Deejpotter/idex-3d-printer/cad/mass-report.csv

part | qty | mass_g_each | mass_g_total | material
688ZZ Bearing | 4 | 5.92 | 23.68 | Steel
8mm Acme Anti Backlash Nut Block | 2 | 55.00 | 110.00 | MASS POM anti-backlash nut
8mm x 500mm Lead Screw | 2 | 153.24 | 306.49 | Steel
Base cross 2040 | 2 | 356.39 | 712.77 | Aluminum 6061
Base rail 4040 | 2 | 655.24 | 1310.48 | Aluminum 6061
Bay rail bottom | 1 | 240.76 | 240.76 | MASS 2020 extrusion
Bay rail mid | 1 | 240.76 | 240.76 | MASS 2020 extrusion
Bay rail top | 1 | 240.76 | 240.76 | MASS 2020 extrusion
Bed carrier bar F | 1 | 111.04 | 111.04 | Aluminum 6061
Bed carrier bar R | 1 | 111.04 | 111.04 | Aluminum 6061
Bed carrier spine | 1 | 32.39 | 32.39 | Aluminum 6061
Bed levelling spacers | 1 | 8.00 | 8.00 | MASS Bed levelling spacers
Bed rail 2020 | 2 | 245.28 | 490.56 | Aluminum 6061
Belt A lower | 1 | 4.80 | 4.80 | MAT GT2 belt
Belt A upper | 1 | 4.80 | 4.80 | MAT GT2 belt
Belt B lower | 1 | 4.80 | 4.80 | MAT GT2 belt
Belt B upper | 1 | 4.80 | 4.80 | MAT GT2 belt
Electronics panel | 1 | 164.74 | 164.74 | MAT Bubbleboard 6mm
Enc door awning | 1 | 324.21 | 324.21 | MAT Bubbleboard 6mm
Enc panel L | 1 | 377.78 | 377.78 | MAT Bubbleboard 6mm
Enc panel R | 1 | 377.78 | 377.78 | MAT Bubbleboard 6mm
Enc panel rear | 1 | 337.97 | 337.97 | MAT Bubbleboard 6mm
Enc panel top | 1 | 344.65 | 344.65 | MAT Bubbleboard 6mm
Enc post FL | 1 | 240.76 | 240.76 | MASS 2020 extrusion
Enc post FR | 1 | 240.76 | 240.76 | MASS 2020 extrusion
Enc post RL | 1 | 240.76 | 240.76 | MASS 2020 extrusion
Enc post RR | 1 | 240.76 | 240.76 | MASS 2020 extrusion
Enc top rail F | 1 | 240.76 | 240.76 | MASS 2020 extrusion
Enc top rail L | 1 | 226.87 | 226.87 | MASS 2020 extrusion
Enc top rail R | 1 | 240.76 | 240.76 | MASS 2020 extrusion
Enc top rail X | 1 | 226.87 | 226.87 | MASS 2020 extrusion
Extruder Orbiter A | 1 | 132.68 | 132.68 | MASS Extruder Orbiter
Extruder Orbiter B | 1 | 132.68 | 132.68 | MASS Extruder Orbiter
GT2 idler pulley (5 mm bore) v1 | 5 | 7.40 | 37.00 | Steel
Heated bed 255x245 | 1 | 588.27 | 588.27 | MASS Heated bed 235x235
Hotend V6 A | 1 | 106.35 | 106.35 | MASS Hotend V6
Hotend V6 B | 1 | 106.35 | 106.35 | MASS Hotend V6
Hotend fan 4010 A | 1 | 16.00 | 16.00 | MASS Hotend fan 4010
Hotend fan 4010 B | 1 | 16.00 | 16.00 | MASS Hotend fan 4010
MGN12 rail X | 1 | 334.89 | 334.89 | Steel
MGN12 rail Y | 2 | 301.40 | 602.79 | Steel
MGN12 rail Z | 2 | 269.12 | 538.23 | Steel
MGN12H block | 10 | 53.47 | 534.67 | MAT MGN12H block
Magnetic sheet | 1 | 90.00 | 90.00 | MASS Magnetic sheet
Nema 17 Stepper Motor | 4 | 390.00 | 1560.00 | MASS NEMA 17 (LDO 48mm)
Octopus Pro V1.1 | 1 | 180.00 | 180.00 | MASS board
PEI spring steel | 1 | 215.00 | 215.00 | MASS PEI spring steel
PSU LRS-200-24 | 1 | 1025.38 | 1025.38 | MASS PSU
PSU LRS-350-24 | 1 | 1300.00 | 1300.00 | MASS PSU
Part fan 5015 A | 1 | 35.00 | 35.00 | MASS Part fan 5015
Part fan 5015 B | 1 | 35.00 | 35.00 | MASS Part fan 5015
Toolhead plate A | 1 | 158.24 | 158.24 | Aluminum 6061
Toolhead plate B | 1 | 158.24 | 158.24 | Aluminum 6061
Top tie 2040 | 1 | 421.19 | 421.19 | Aluminum 6061
Upright 4040 | 2 | 618.92 | 1237.85 | Aluminum 6061
X beam 2040 | 1 | 421.19 | 421.19 | Aluminum 6061
X belt clamp A | 1 | 32.22 | 32.22 | Steel
X belt clamp B | 1 | 32.22 | 32.22 | Steel
X idler bracket A | 1 | 37.07 | 37.07 | Aluminum 6061
X idler bracket B | 1 | 35.12 | 35.12 | Aluminum 6061
X motor mount A | 1 | 46.18 | 46.18 | Aluminum 6061
X motor mount B | 1 | 46.18 | 46.18 | Aluminum 6061
Y belt clamp | 1 | 59.45 | 59.45 | Aluminum 6061
Y belt run 1 | 1 | 4.48 | 4.48 | MAT GT2 belt
Y belt run 2 | 1 | 4.48 | 4.48 | MAT GT2 belt
Y idler bracket | 1 | 37.20 | 37.20 | Aluminum 6061
Y motor mount | 1 | 67.79 | 67.79 | Aluminum 6061
Z belt run 1 | 1 | 4.04 | 4.04 | MAT GT2 belt
Z belt run 2 | 1 | 4.04 | 4.04 | MAT GT2 belt
Z carriage plate L | 1 | 155.52 | 155.52 | Aluminum 6061
Z carriage plate R | 1 | 155.52 | 155.52 | Aluminum 6061
Z motor mount | 1 | 189.02 | 189.02 | Steel
Z screw block base L | 1 | 35.91 | 35.91 | Aluminum 6061
Z screw block base R | 1 | 35.91 | 35.91 | Aluminum 6061
Z screw block top L | 1 | 38.47 | 38.47 | Aluminum 6061
Z screw block top R | 1 | 38.47 | 38.47 | Aluminum 6061
pulley gt2 6.35 bore | 6 | 15.32 | 91.94 | Steel
