Deejpotter/idex-3d-printer/cad/idex-printer-assembly.step

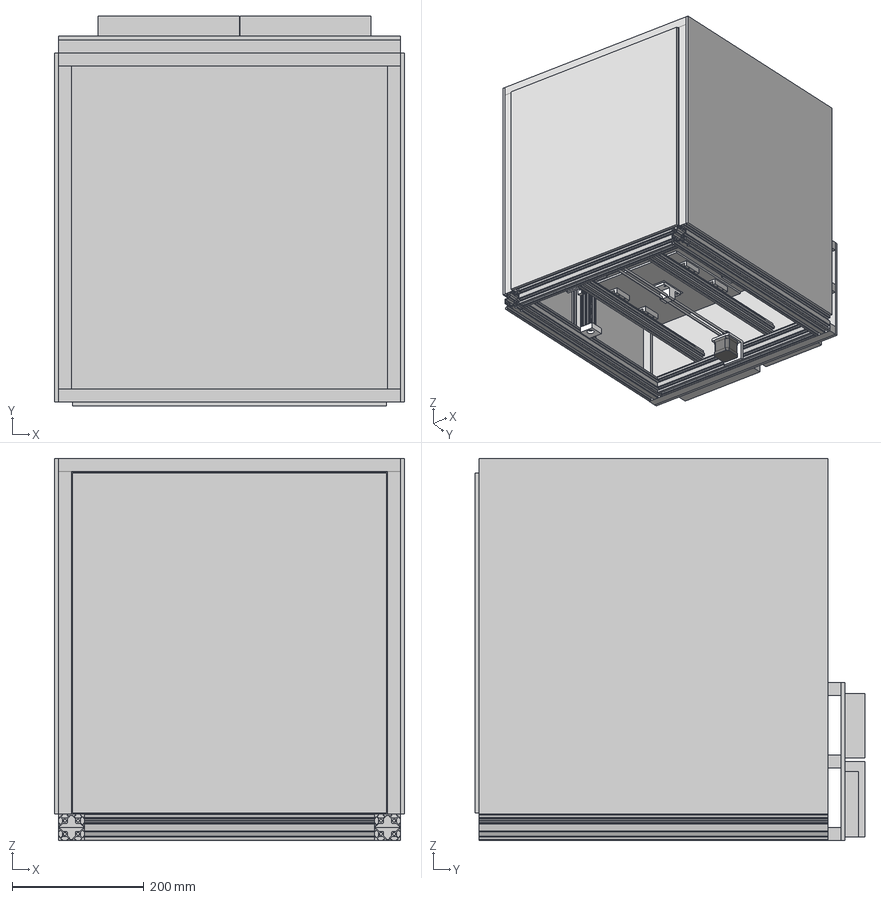
[picture p3: CAD file, 2026-11-12]
cad/idex-printer-assembly.step
532.0 x 592.0 x 580.0 mm
pulley gt2 6.35 bore x 6
GT2 idler pulley (5 mm bore) x 5
Nema 17 Stepper Motor x 4
Trapezoidal lead screw tr8x8-4 x 2
8mm Acme Anti Backlash Nut Block x 2
688ZZ Bearing x 4
