Deejpotter/idex-3d-printer/(list of files, cad)

Other CAD files:
cad/idex-printer-assembly.f3d
