Deejpotter/idex-3d-printer/docs/build-spec.html

Build notes · 10 Nov 2026 · replaces the Apr 2025 Dual 3D Printer

# Cheap Fast IDEX

A dual-extrusion printer, direct drive, as cheap as possible and as fast as the frame allows — built on the layout you already drew. This version explains the reasoning rather than just stating it, so you can argue with the conclusions.

Lesson 1

## A printer is a weight on the end of a spring

Pin a ruler to the edge of a desk, flick the free end, and it wobbles at one particular rate. Not a random rate — one specific one. Make the ruler stick out further and the wobble slows down. Stick a lump of Blu-Tack on the end and it slows down again.

Your print head is that ruler. It hangs off a belt, which hangs off brackets, which bolt to a frame. All of that flexes a little. So when a motor yanks the head sideways and then stops, the head keeps wobbling for a moment. That wobble prints as ringing — the faint repeated echo you see just after a sharp corner.

The rate it wobbles at is the natural frequency, measured in hertz (Hz, wobbles per second). It depends on exactly two things:

natural frequency = (1 ÷ 2π) × √( stiffness ÷ mass )

Stiffness is how hard the structure resists being pushed out of shape, in newtons per metre (N/m) — push with so many newtons, it deflects so many metres. A high number is a rigid thing. Mass is simply the weight that's moving, in kilograms.

In plain terms

Stiffer frame → faster wobble → better. Heavier head → slower wobble → worse. Those are your only two levers, and the square root means you need to quadruple stiffness, or quarter the mass, to double the frequency.

Why do we want a fast wobble? Because a fast wobble dies out quickly and is easier for the firmware to cancel. That's the next two lessons.

Lesson 2

## In a chain of springs, the floppiest one wins

This is the idea that decides your whole build, so it's worth getting properly.

The head isn't connected to the motor by one spring. It's a chain: the belt stretches a bit, the bracket holding the motor flexes a bit, the frame those bolt to bends a bit. Springs in a chain like this are called springs in series.

Here's the counterintuitive bit. If you hook a very stiff spring to a very floppy one, the pair is floppier than the floppy one alone. Pull on the chain and the floppy one does nearly all the stretching. Making the stiff one even stiffer changes almost nothing.

The belt is nearly seven times stiffer than the bracket, and contributes almost nothing. Replace the belt with an infinitely rigid steel bar and you'd get 60,000 instead of 52,000 — a 15% gain. Double the bracket stiffness and you get 92,000 — a 77% gain.

This is why people's intuition about printers is usually wrong. Everyone obsesses over belt tension and carriage weight. The actual floppy link is nearly always the printed plastic bracket holding the motor or the idler pulley.

How we know the model is right

If you calculate using the belt alone, you predict the X axis wobbles at 123 Hz. Real bedslingers measure 32–45 Hz. The gap is the brackets. Once they're included, the model lands on 32.5 Hz for a printed-bracket machine — which is what an Ender 3 actually measures. That's the check that says these numbers can be trusted.

Lesson 3

## What the wobble costs you in speed

Modern firmware can cancel ringing. The trick is called input shaping: the firmware knows your wobble frequency, so when it commands a sharp move it splits it into two nudges, timed so the second nudge's wobble cancels the first one's. Like catching a swing at exactly the right moment to stop it dead.

It works brilliantly, but it has a price. The two nudges are spread over time, which slightly smears sharp corners. The faster you accelerate, the more smearing. And the lower your wobble frequency, the further apart the nudges must be, so the worse the smearing at any given acceleration.

That gives a practical ceiling on acceleration, roughly:

max acceleration (mm/s²) ≈ frequency² × 0.022

The square is what matters. Going from 30 Hz to 60 Hz doesn't double your acceleration — it quadruples it.

What frequency buys you
Frequency | Usable acceleration | Feels like
22 Hz | 1,000 mm/s² | a tired old bedslinger
33 Hz | 2,400 mm/s² | stock Ender 3
45 Hz | 4,500 mm/s² | a good budget build
55 Hz | 6,700 mm/s² | genuinely quick
65 Hz | 9,300 mm/s² | Voron territory

"Acceleration" in mm/s² is how hard the head can change speed. It matters more than top speed, because on a real part full of short segments and corners the head spends most of its life speeding up and slowing down and never reaches top speed at all.

Lesson 4

## Your machine, with those rules applied

Now we can just read the answers off. Two axes move fast: X (the print head sliding along the beam) and Y (the bed sliding back and forth — a layout called a bedslinger, which is what you drew).

### The X axis — the print head

X carriage, three bracket choices
Head build | Mass | Printed brackets | Ribbed + inserts | Aluminium
Your Titan + low-profile NEMA 17 owned | 667 g | 29.9 Hz | 44.5 Hz | 64.4 Hz
A light geared extruder would cost ~$120 | 385 g | 39.3 Hz | 58.6 Hz | 84.7 Hz

Read that across, not down. Buying a fancy light extruder and keeping printed brackets gets you 39 Hz. Keeping the extruder you already own and making the brackets from aluminium gets you 64 Hz — and costs less.

The main recommendation

Don't buy lightweight extruders. Buy aluminium brackets. Your existing Titans and low-profile NEMA 17s are fine for direct drive. Mass is the lever everyone reaches for; stiffness is the lever that actually moves.

### The Y axis — the bed

Y bed, same three bracket choices
Bed build | Mass | Printed | Ribbed | Aluminium
As you drew it — 235 bed plus a 185 support plate | 1300 g | 21.6 Hz | 32.5 Hz | 48.1 Hz
Bed mounted straight to the rail blocks | 1020 g | 24.4 Hz | 36.7 Hz | 54.3 Hz
Drop to a 200 × 200 bed | 850 g | 26.7 Hz | 40.2 Hz | 59.5 Hz

Y is slower than X in every single row, because the bed is heavier than the head. And the firmware applies one acceleration limit to the whole machine, so the machine runs at whichever axis is worse. Money spent making X faster than Y buys you nothing at all.

A free improvement

Your design has a 235 mm heated bed and a separate 185 mm support plate underneath it. Bolt the bed straight to the linear rail blocks and you delete 280 g, lifting Y by about 12%. It costs nothing and removes a part.

Where the whole machine lands
Build | X | Y | Machine runs at
Printed brackets, bed as drawn | 2,000 | 1,000 | 1,000 mm/s²
Ribbed printed brackets, support plate deleted | 4,400 | 3,000 | 3,000 mm/s²
Aluminium brackets, support plate deleted | 9,100 | 6,500 | 6,500 mm/s²
Aluminium + 200 mm bed + light extruders | 15,800 | 7,800 | 7,800 mm/s²

The third row is the sweet spot: six and a half times the acceleration of the first, bought almost entirely with bracket material and one deleted part.

Lesson 5

## Your extrusion choice, checked

You want to stay on 20-series V-slot so the parts stay reusable. Good news: the numbers say that's nearly free.

The frame is a third spring in that chain from Lesson 2. By the floppiest-link rule, it only matters if it's as floppy as the bracket. Stiffness of a beam comes from its second moment of area (symbol I, in cm⁴) — a number describing how the metal is distributed about the bending axis. Material far from the centre counts enormously more, which is why a tall profile stood on edge is so much stiffer than a square one.

Every profile, for reference — X beam 600 mm span, upright 400 mm cantilever
Profile | I (cm⁴) | X beam stiffness | Upright stiffness | X frequency | Accel
2020 V-slot | 0.70 | 107 kN/m | 23 kN/m | 36.5 Hz | 2,900
2040 V-slot | 4.65 | 713 kN/m | 150 kN/m | 43.0 Hz | 4,100
2060 V-slot | 14.5 | 2,223 kN/m | 469 kN/m | 44.0 Hz | 4,300
2080 V-slot | 32.5 | 4,983 kN/m | 1,051 kN/m | 44.3 Hz | 4,300
3030 T-slot | 3.60 | 552 kN/m | 116 kN/m | 42.5 Hz | 4,000
3060 T-slot | 22.5 | 3,450 kN/m | 728 kN/m | 44.2 Hz | 4,300
4040 T-slot | 9.00 | 1,380 kN/m | 291 kN/m | 43.7 Hz | 4,200
4080 T-slot | 50.0 | 7,667 kN/m | 1,617 kN/m | 44.4 Hz | 4,300

Read the frequency column and the profiles all look the same — 2040 gives 43.0 Hz, 4080 gives 44.4 Hz. That table assumes printed brackets, though, and a printed bracket is so floppy it swamps everything behind it. Once you fit the aluminium brackets from Lesson 4, the bracket stops being the worst link and the frame starts to show.

### First, a correction: 40×40 V-slot is 20-series

You used 40 × 40 V-slot for the uprights, not 2040 — and that's still 20-series hardware: the same M5 T-nuts, the same 20 mm slot pitch, the same accessories. "20-series" describes the slot, not the outside dimension, so staying reusable never meant staying small. 40×40 V-slot has an I of about 7.5 cm⁴ against 2040's 4.65, and a pair of 400 mm uprights gives 485 kN/m rather than 301.

So your original choice was already better than what I assumed. But it turns out the extrusion was never the thing to worry about.

### Redone with aluminium brackets — and with the uprights counted

The X beam isn't the only frame member in the chain. When the head accelerates along the beam, the whole gantry reacts, and the two Z uprights sway. They're a cantilever — fixed at the bottom, free at the top — which is a much floppier arrangement than a beam supported at both ends.

Same profile for beam and uprights, aluminium brackets
Profile | Beam | Two uprights | Chain total | X frequency | X accel
2020 | 107 kN/m | 45 kN/m | 24.7 kN/m | 30.6 Hz | 2,100
2040 | 713 kN/m | 301 kN/m | 72.0 kN/m | 52.3 Hz | 6,000
2060 | 2,223 kN/m | 938 kN/m | 93.6 kN/m | 59.6 Hz | 7,800
2080 | 4,983 kN/m | 2,102 kN/m | 101.6 kN/m | 62.1 Hz | 8,500

So the profile does matter after all, once the brackets are good: 2040 → 2060 is worth 30% more acceleration. But the next question is where to spend it, and the answer is not the obvious one.

Upgrading one member at a time
Beam / uprights | X frequency | X accel | Gain
2040 beam / 2040 uprights | 52.3 Hz | 6,000 | —
2060 beam / 2040 uprights | 54.2 Hz | 6,500 | +8%
2040 beam / 2060 uprights | 57.1 Hz | 7,200 | +20%
2060 beam / 2060 uprights | 59.6 Hz | 7,800 | +30%
2080 beam / 2080 uprights | 62.1 Hz | 8,500 | +42%

The uprights matter more than the beam

Upgrading the uprights alone buys +20%. Upgrading the beam alone buys +8%. Two 2040 uprights together give 301 kN/m against the beam's 713 — they are the floppier of the two, so by Lesson 2 they're where the gain is. Most people would have upgraded the beam.

### But remember what caps the machine

Y runs at 6,500 mm/s² with aluminium brackets and the support plate deleted, and the firmware uses one limit for the whole machine. So:

Build | X can do | Y can do | Machine runs at
2040 beam / 2040 uprights | 6,000 | 6,500 | 6,000 — X-limited
2040 beam / 2060 uprights | 7,200 | 6,500 | 6,500 — Y-limited
2060 beam / 2060 uprights | 7,800 | 6,500 | 6,500 — no further gain
2080 everywhere | 8,500 | 6,500 | 6,500 — no further gain

What to actually buy: nothing

- Your 40×40 V-slot uprights are already enough. They give X 6,600 mm/s², which just clears Y's 6,500. Buying 2060 would take X to 7,200 and leave the machine at 6,500 regardless.
- X beam: 2040 on edge is enough — unless you later drop to a 200 mm bed, which lifts Y to 7,800 and makes a 2060 beam worth revisiting.
- Never 2020 for a beam or upright. Two 2020 uprights are 45 kN/m, floppier than the bracket itself, and drag the machine to 2,100 mm/s².
- Bed carrier: 2020 is fine — it moves, so keep it light.

The 30- and 40-series T-slot rows in the reference table are kept for if you ever scale this design up. On this machine they'd buy nothing — and now that the uprights are settled, Lesson 10 shows what actually does.

Since every axis runs on MGN linear rails — proper steel rails with recirculating ball bearings, rather than wheels — you never need the V-groove for motion. It's purely a bonus for mounting things later, which is exactly the reusability you're after.

Lesson 6

## Motor torque, and why you don't need a NEMA 23

Torque is twisting force, measured in newton-metres (Nm). One newton-metre is a one-newton push on the end of a one-metre lever — roughly the force of holding up a 100 g apple, a metre out.

A belt motor's lever is the radius of its pulley. Your GT2 20-tooth pulley has a working radius of only 6.366 mm, so the motor has a very short lever. That sounds bad but it's the opposite: a short lever means a small torque produces a large pull on the belt. It's gearing in your favour.

torque needed = mass × acceleration × pulley radius (+ a bit to spin the motor's own rotor)

Work it through for the heaviest demand on the machine and the answer is almost embarrassing:

Torque demanded vs a standard NEMA 17's 0.45 Nm
Axis | Motor | Needs | Spare | Have it?
X1 — carriage A | NEMA 17, 42×40 | 0.060 Nm | 7.5× | owned
X2 — carriage B | NEMA 17, 42×40 | 0.060 Nm | 7.5× | owned
Y — bed | NEMA 17, 42×40 | 0.044 Nm | 10.2× | owned
Z — both lead screws | NEMA 17, 42×40 | 0.175 Nm | 2.6× | buy 1
E1 — extruder | Low-profile NEMA 17 | 0.080 Nm | 5.6× | owned
E2 — extruder | Low-profile NEMA 17 | 0.080 Nm | 5.6× | owned

"NEMA 17" is just a mounting standard — it means a 42 × 42 mm faceplate, nothing about power. NEMA 23 means 57 × 57 mm.

The hardest-working axis on the whole printer is Z, lifting the gantry on two lead screws, and it asks for 0.175 Nm. A NEMA 23 delivers 1.0–2.0 Nm. That's six to eleven times more than the worst case anywhere on the machine, for an extra ~700 g of motor and about 2.8 amps — which is more current than a TMC2209 driver chip can give, so you'd have to buy external drivers as well. On a build where the goal is cheap, it's spending money to gain nothing.

Answer to your question

No NEMA 23. Keep the single NEMA 17 belt-linking both lead screws, exactly as you have it — it has 2.6× margin, which is healthy. You own five of the six motors you need; buy one standard NEMA 17.

Lesson 7

## Why motors go weak when they spin fast

A spinning motor acts as a generator, pushing back a voltage of its own against the supply. This is back-EMF (electromotive force — just an old word for voltage). The faster it spins, the harder it pushes back.

Your power supply has to overcome that back-voltage before any current can flow into the coils, and current is what makes torque. When back-EMF approaches your supply voltage, current stops flowing and the motor goes limp — no matter how beefy it is.

Voltage left over after back-EMF ("headroom")
Head speed | Motor rpm | Back-EMF | on 12 V | on 24 V | on 36 V
200 mm/s | 300 | 11.0 V | 1.0 V | 13.0 V | 25.0 V
300 mm/s | 450 | 16.5 V | −4.5 V | 7.5 V | 19.5 V
400 mm/s | 600 | 22.0 V | −10.0 V | 2.0 V | 14.0 V
500 mm/s | 750 | 27.5 V | −15.5 V | −3.5 V | 8.5 V

A negative number means the motor is generating more voltage than you're feeding it — it simply cannot go that fast. On 12 V you run out at about 250 mm/s. On 24 V you reach roughly 400 mm/s, which is past what the frame can use anyway.

Decision

24 V. It is the cheapest single thing you can do for speed. 36 V would go further but costs more and narrows your board options for no benefit you could actually use.

### Power supply size

What draws power | Watts
Heated bed, 235 × 235 | 199
Two hotends, 40 W each | 80
Six stepper motors | 60
Cooling fans | 25
Controller and single-board computer | 15
Total | 379 W — that's 15.8 A at 24 V

A 24 V 500 W supply leaves 32% spare. The bed is over half the total, so a smaller bed later would let you drop to 400 W.

Lesson 8

## What IDEX actually is, and what it costs

IDEX stands for Independent Dual EXtruder. Two complete print heads sit on the same beam, each with its own motor and its own belt, so either can move while the other sits parked at the end.

Compare that to the E3D Chimera in your current design, which is one block with two nozzles side by side, both always moving together. The idle nozzle drags over your print and dribbles on it. IDEX parks the idle nozzle off to the side instead, which is the main reason it gives cleaner dual-colour results.

IDEX also unlocks duplicate mode: both heads print the same object at the same time, two copies in the time of one. That's a genuine throughput win rather than a convenience.

The cost is beam length. Both heads need to reach the whole bed, and both need somewhere to park clear of it:

Measurement | Value | Note
Bed width | 235 mm | your existing bed
Carriage width | 65 mm | a compact direct-drive head
Travel needed | 385 mm | bed + both parking spots
MGN12 rail length | 450 → buy 500 mm | your longest is 350 mm
X beam length | ~600 mm | plus both motor mounts
Build volume | 235 × 235 × 250 | single head
Duplicate mode | 85 mm per copy | two at once

Your 390 mm beam is simply too short for this. A ~600 mm length of 2040 or 2060 fixes it.

### Why direct drive was the right call

Direct drive means the motor that pushes filament sits on the moving head. Bowden means it sits on the frame and pushes filament down a long tube. Bowden gives a lighter head, but the filament squashes inside that tube like a spring, so when you command a retraction the nozzle responds late and vaguely.

For dual extrusion that matters more than usual, because precise retraction is exactly what stops the parked nozzle oozing. You chose direct drive, and Lesson 4 shows the mass penalty barely costs you anything once the brackets are aluminium. It's the right call.

Lesson 9

## Making the brackets: mill them, or buy them?

Before the cost question, something that changes what "a stiff bracket" even means.

Take a 3 mm aluminium plate, 70 mm wide, sticking out 40 mm. Push on it two different ways:

How the load hits it | Stiffness
Across the face — bending it like a diving board | 509 kN/m
In the plate's own plane — pushing along it edge-on | 500× stiffer

Same plate, same metal, same bolts. The only difference is which way the force arrives. Think of a sheet of paper: floppy flat, but almost impossible to squash edge-on.

So "aluminium bracket" was shorthand

What Lesson 4 really wants is a bracket that isn't loaded in bending. A cheap 3 mm bought plate, turned the right way, beats a thick milled block turned the wrong way. Orientation matters more than material or thickness.

Design every motor and idler mount so the belt pulls along the plate, not across it. Standard V-slot motor plates are already designed this way — the motor bolts to the face and the belt runs in the plate's plane. Use at least two bolts into the extrusion, with proper T-nuts; past that point the bolted joint is the limit, not the plate, which lands you around the 150 kN/m "aluminium" column.

### Now the cost question

CNC Kitchen measured an A350 — stiffer than your A250 — cutting 4 mm aluminium at 250 mm/min with a 0.3 mm stepdown, with heavy chatter. Taking that as the optimistic case for a 70 × 40 × 6 mm bracket with six holes:

Step | Time
20 passes round the perimeter | 17.6 min
Six holes | 3.8 min
Workholding, probing, tool change, tabs, cleanup | 30 min
Per bracket | 51 min, supervised
Ten brackets | 8.6 hours

Four ways to get ten brackets
Option | Parts cost | Your time | Catch
Mill on the Snapmaker | ~$100 | 8.6 h | chatter finish, broken end mills, ten setups
Maker Store plates | ~$145 | 0.5 h | dearest, but local and known to fit
AliExpress plates | ~$55 | 0.5 h | 2–5 week shipping, QC lottery
Laser cut custom, AU | ~$160 | 1.0 h | any shape, single piece, ~5 business days

Milling costs roughly what the plates cost — the 6061 stock is ~$50 and you'll get through three or more carbide single-flute end mills at ~$15 each — and then asks for 8.6 hours of supervised machine time on top, to produce parts with a worse finish and less accuracy than stamped plates. The A250 isn't rigid enough for aluminium to be pleasant; it's a job it can do, not one it's good at.

Answer

Buy the plates and design around them. Your existing model already uses this ecosystem — Easy Build Plate 3×6, V-Slot Gantry Plate 20 mm, Threaded Rod Plate NEMA 17, Black Angle Corner Connector are all standard catalogue parts. Carry on doing that.

AliExpress for the standard shapes since it's your preference and it's a third of the price; order early and order spares, because the shipping is the real cost. Maker Store for anything you need this week or need to be certain fits.

For the two or three brackets where no standard plate works, draw them as flat 2D profiles and have them laser cut rather than milled. Ferracut in Dandenong takes DXF uploads and cuts aluminium up to 12 mm — about half an hour from you. A single-piece laser-cut bracket is stiffer than bolting two plates together, and you skip the 8.6 hours.

Keep the Snapmaker's CNC for one-offs you need the same day, and for the jobs it's genuinely good at — wood, acrylic, carbon fibre.

Lesson 10

## How it all bolts together — and where I had this wrong

You pushed back on this and you were right. I went back into the assembly and read it properly this time: every occurrence, every transform, every fastener position. Several things I told you earlier were wrong, and the correction changes the whole recommendation.

Corrections

- The assembly has 294 occurrences, not 77. (77 is just the Frame's child count — I quoted a sub-total as the whole.)
- It has 153 fasteners, not 140.
- It records 2 joints and 4 rigid groups across all 294 occurrences, with 0 user parameters and a 539-item timeline. Position is held by captured snapshots, not constraints.
- And the big one: the upright feet are already reinforced. I said they weren't.

### What the feet actually do

Each upright is a 40 × 40 V-slot sitting on a 40 × 40 base rail, and each foot carries:

- 4 × M5 blind screws up through the base rail's top wall into the four tapped bores of the upright — a 2 × 2 pattern at ±10 mm, which is exactly the 4040's four cell centres. All four are used.
- 2 × 90° joining plates on the outer face, 4 mm thick, 10 M5 screws between them. All four plates in the design are at the upright feet — not "all up in the Z assembly" as I claimed.

### Why blind joining is the strong option — your instinct was correct

A bolted butt joint is not a hinge with a spring in it. Once the bolts are preloaded, the two end faces are clamped together, and the joint behaves as effectively rigid right up until the moment that tries to pull the faces apart exceeds the clamping force. That is called gapping, and until it happens the joint is as stiff as solid metal.

Four M5 bolts at ±10 mm, preloaded to even a conservative 2.5 kN each, resist gapping up to roughly 130 N·m. The moment this machine actually applies at an upright foot — the toolhead at 1.42 kg accelerating hard, 350 mm up — is about 3 N·m. You are a factor of forty inside the limit. The joint never gaps, never slips, and never becomes the floppy spring I modelled it as.

My earlier figure of 91 kN/m effectively modelled a single centre bolt. That is the case where blind joining is genuinely weak, and it is where the "always use corner brackets" folklore comes from. With all four bores used, it does not apply.

Same 40 × 40 uprights, 350 mm, four ways of fixing the bottom — corrected
How the upright meets the base | Pair stiffness | X frequency | Machine accel | Gain
4 blind bolts — what you drew | 478 kN/m | 40.1 Hz | 3,546 | —
Plus a gusset on the loaded face | 636 kN/m | 41.0 Hz | 3,719 | +5%
Plus gussets on both loaded faces | 670 kN/m | 41.2 Hz | 3,747 | +6%
A perfectly rigid, welded foot | 724 kN/m | 41.4 Hz | 3,787 | +7%

Read the last column. Even replacing the foot with a weld buys 7%. I previously told you this joint was worth +51% and that it outweighed everything in Lesson 5. It is worth almost nothing. Forget the eight corner brackets; do not buy them.

### So where does the speed actually go? Back to Lesson 2

The floppiest spring wins, and once the foot is modelled correctly the floppiest spring is the one Lesson 4 already pointed at — the toolhead mount. A 576 g plate hanging off a single MGN12H block is roughly 141 kN/m, against 513 for the belt and 478 for the gantry. It is three times floppier than anything else in the chain, so it sets the answer on its own.

Changing the mount, with the foot left exactly as you drew it
Toolhead build | Mass | X frequency | Machine accel | Gain
1 × MGN12H + 576 g plate — as drawn | 1.42 kg | 40.1 Hz | 3,546 | —
2 × MGN12H, same heavy plate | 1.47 kg | 47.7 Hz | 5,019 | +42%
2 × MGN12H + 300 g aluminium plate | 1.14 kg | 54.1 Hz | 6,471 | +83%
2 × MGN12H, IDEX carriage ~900 g | 0.90 kg | 60.9 Hz | 8,197 | +131%
2 × MGN12H, light IDEX ~750 g | 0.75 kg | 66.7 Hz | 9,836 | +177%

The corrected headline

Adding a second MGN12H block under each carriage is worth +42% on its own, costs about $8, and needs no change to the frame at all. Every foot-related modification put together is worth 7%. Spend the effort on the carriage, not the corners.

Which machine these numbers describe

Everything in this lesson is your existing design as drawn — the 1.42 kg Chimera head on one block. Lesson 4 costs the rebuild, with a 667 g IDEX carriage, and lands at 6,500 mm/s². In the rebuild the second block still helps X, but the machine is then limited by Y, the bed, so X gains past 6,500 are wasted. Fix the carriage because it is cheap and it unblocks X; after that, every further gain comes from the bed.

### Two things that are genuinely wrong at the feet

The joint type is right. The detailing is not.

Thread engagement, M5 into 6063 aluminium (2.2 mm wall under the head)
Screw | Engagement | Thread strip load | Verdict
M5 × 8 — what the model uses | 5.8 mm | 6.8 kN | too short below the preload you want
M5 × 12 | 9.8 mm | 11.5 kN | marginal — just under 2 × diameter
M5 × 16 | 13.8 mm | 16.3 kN | correct comfortably past 2 × diameter

- Every blind screw in the model is an M5 × 8. Through a 2.2 mm wall that leaves 5.8 mm of thread in aluminium — below the rule of thumb of two diameters, and below the preload the joint needs to stay clamped. Preload is the entire reason a blind joint is stiff, so this is the one detail that could turn your good joint into my bad one. Use M5 × 16 at the feet. It is the cheapest fix in this document.
- Both gussets are on the same face. They sit on the outer X face of each upright, so they resist the upright tipping in Y. The toolhead accelerates in X, which tips the uprights the other way — the plane the gussets do nothing for. They are not harmful and they help the Z-lift loads, but do not count them as X stiffness. Given the table above, it is not worth moving them.

### What the model does not fasten at all

The Frame (64 fasteners), X axis (43) and Z axis (40) are reasonably detailed. Two areas are not, so when you rebuild you will be designing these joints rather than copying them:

- The whole Y axis — zero fasteners. Not one screw in the entire sub-assembly: nothing holding the Y motor mount, the pulley bracket, the bed support plate, the MGN blocks or the bed-levelling hardware. Roughly 20 missing.
- The toolhead — four. Two M3 screws and two M3 nuts, inside one Titan. The carriage plate, both NEMA 17s and both extruder bodies are floating. Another 20 or so.
- The Z top motor has three M4 screws, where a NEMA 17 has four mounting holes.

### Making it easier to assemble

- Drop-in T-nuts everywhere. Never sliding ones. The single biggest assembly-ease win. A sliding T-nut has to be threaded in from the open end before you close that extrusion off — forget one and you dismantle the frame to add it. You already use 32 ball-spring nuts; replace the 10 sliding ones too.
- Buy M5 in 8, 12, 16 and 20 mm. M5 × 8 is right for a T-nut under a 3 mm plate and wrong for almost everything else. The feet need 16.
- Keep a ball-end hex driver. The blind screws go in down a long clearance hole inside the base rail's slot, at an angle a straight key will not reach.
- Build the X beam as a complete unit on the bench — rail, both carriages, both motors, idlers, belts — then lift it onto the Z carriages as one piece.
- Count your T-nuts into each extrusion before you close a corner. Write the number on masking tape. Add two spares per slot.
- Torque the blind screws properly, in a cross pattern, like a wheel. Preload is what makes this joint work; an under-torqued blind bolt really is the floppy hinge I wrongly described.

Lesson 11

## What to buy

Item | Qty | Why
V-slot motor + idler plates, bought not milled | ~10 | highest-value item — Lessons 2, 4 and 9. AliExpress; spares too
Standard NEMA 17 | 1 | you have 3 of the 4 standard motors needed
MGN12 rail, 500 mm | 1 | the X axis; you already own the blocks
Control board with 6+ drivers — BTT Manta M8P + CB1 | 1 | board and computer in one, cheaper than separate
TMC2209 stepper drivers | 6 | one per motor
24 V 500 W power supply | 1 | Lesson 7
V6-class hotends | 2 | IDEX needs two separate heads; a Chimera can't be split
GT2 belt, idlers, 20T pulley | 2nd set | the second X axis
MGN12H carriage blocks — a second one per carriage | 2 | +42% acceleration on the machine as drawn — Lesson 10. About $8 each and no frame change
M5 × 16 button screws, for the upright feet | 8 | the model uses M5 × 8, which leaves only 5.8 mm of thread in aluminium — Lesson 10
Drop-in / ball-spring M5 T-nuts | 60+ | replaces the 10 sliding ones; buy well over what you count
M5 button screws — 8, 12, 16 and 20 mm | assortment | 8 mm alone will not reach through a bracket stack
2040 V-slot — 480 mm X beam, base perimeter | — | 480 mm is derived in the model, not guessed — Lesson 13. Seconds from work; uprights you already have

Surplus: the E3D Chimera is worth selling — it's the opposite of IDEX. So is the 576 g carriage plate.

Lesson 12

## Build order, and the step people skip

# | Step | Why here

1 | Frame — your 40×40 V-slot uprights, 2040 base, tied at the top, all four blind bores used at every foot, with M5 × 16, torqued in a cross pattern | the blind joint is the right one; it just needs enough thread and enough preload — Lesson 10
2 | Belt-linked dual lead-screw Z, lifting the gantry | carries over from your design unchanged
3 | Bed carrier — bed straight onto the rail blocks | it's the limiting axis; fix it first
4 | X beam with one carriage, aluminium brackets | prove it as a single-extruder printer
5 | Measure the resonance. Compare to this report. | the step people skip
6 | Second carriage, second hotend, IDEX config | only once step 5 agrees
7 | Nozzle offset calibration and prime tower tuning | the fiddliest part of commissioning

Step 5 takes an hour. You stick an accelerometer on the head, the firmware shakes the axis and tells you its frequency. If it comes back well below the aluminium column, something is flexing that shouldn't be — and finding that with one carriage on the beam is far easier than with two.

### Three things that bite IDEX builds

- The two carriages won't match. They sit at different distances from their motors, so their belts are different lengths and they ring at different frequencies. The firmware lets you set a different correction per carriage for X, but the Y setting must be identical for both. Keep the two belt paths as close to mirror images as you can.
- The parked nozzle still oozes, just away from your part. You'll want a prime tower — a small sacrificial pillar printed alongside, where each nozzle wipes itself clean before returning.
- Two nozzles means two sets of offsets. You probe with one head, then measure how far the second sits from it in X, Y and Z. Set aside an evening; this is the part that tests patience.

Lesson 13

## The model, rebuilt so it can actually be changed

The old assembly could not be flexed. It had 0 user parameters, 2 joints and 539 timeline items for 294 occurrences, with position held by captured snapshots instead of constraints — so changing one dimension changed nothing else. That blocks every other improvement in this document, so it was the first thing to fix.

There is now a new parametric frame model alongside it. The old one is untouched.

| Old assembly | New frame model
User parameters | 0 | 18
Timeline items | 539 | 16
Sketches fully constrained | — | 8 of 8
Change the build volume and the frame follows | no | yes

### The numbers that drive it

You set the build volume; the frame sizes itself. The one worth understanding is the X beam, because IDEX is what makes it long:

x_beam_len = build_x + 2 × carriage_w + 2 × park_gap + 2 × end_allow

That is the build area, plus a whole carriage parked clear at each end, plus the gap that keeps a parked nozzle off your print, plus room for a motor and an idler. At 230 mm build it comes to 480 mm — not the ~600 mm I guessed earlier. A 500 mm MGN12 rail fits it exactly.

This is the real cost of IDEX, and now you can see it move: widen a carriage from 60 to 75 mm and the beam grows to 510 mm and the whole frame with it. The other drivers are build_y (the frame is 2 × build_y + 60 deep, because a bedslinger needs to swing the bed its full depth), upright_h, and p40 / p20 for the profile faces.

### It uses your real V-slot profiles, not boxes

Your hub already holds the genuine OpenBuilds V-slot parts, in the Extrusion folder of the old project. The problem is they're fixed lengths — 300, 350, 390 mm — and this frame needs 480, 500 and 530. So rather than insert a wrong-length bar, I took the real cross-section off the end face of each part and re-drew it natively, then extruded it to the parametric length.

You get the true profile — every slot, every internal web — with a length that still follows the parameters. The traced sections came out within 0.003 mm² of the originals:

Profile | Section area | Curves traced | Tapped end bores
40 × 40 V-slot | 458.46 mm² | 164 | four, Ø4.6, at (±10, ±10)
20 × 40 V-slot | 299.99 mm² | 112 | two, Ø4.2, at (0, ±10)
20 × 20 V-slot | 171.40 mm² | 69 | one, Ø4.2, dead centre

The real geometry settles Lesson 10

The 4040's four bores sit at exactly (±10, ±10) — the 20 mm pattern the blind-joint calculation assumed, confirmed off your actual part rather than from a catalogue. Your uprights land on all four, which is why that joint is strong.

It also shows where blind joining is weak. The 2020 has a single central bore — that is precisely the one-bolt case my wrong 91 kN/m figure described. Blind-bolting a 2020 end gives you almost no moment resistance. On 2020 members, use a corner bracket; on the 4040 uprights, don't bother.

### How it holds together

Fusion occurrence positions aren't parametric on their own — only lengths are. The first attempt proved it: driving the uprights to 620 mm grew them correctly but left the top tie stranded at its old height. So each real part is now fixed by a rigid joint to the parametric layout body underneath it. Move a parameter, the layout moves, the joints drag the real extrusions with them.

| Old assembly | New model
User parameters | 0 | 29
Timeline items | 539 | 83
Joints | 2 | 10
Real extrusion parts | — | 10 (4.48 kg)
Change the build volume and the frame follows | no | yes

Verified by flexing, not by looking. Uprights to 620, build to 300 × 300, carriage to 80 — the extrusions changed length, the top tie rode up to 660–680, the envelope tracked every step, and everything returned exactly to 480 × 530 × 560 with a clean timeline. Worst placement error anywhere: 0.010 mm, which is the rounding on the profile's outer corners.

Two things worth knowing about how it's built. The six profile sketches are traced real geometry, so they aren't dimensioned — position comes from the joints instead, which is why the layout bodies stay in the file (hidden). And the 20 × 40 members needed their joint angle set explicitly: a rigid joint between two flat faces picks its own rotation about the face normal, and on a non-square profile it lands 90° out.

### Organised by sub-assembly

The model is now grouped the way the machine is built and the way Lesson 15 prices it: A – Frame (7 parts, 3.59 kg), B – X gantry, D – Y and bed, plus empty containers waiting for C – Toolhead A, C – Toolhead B, E – Z axis and G – Electronics. Two toolheads get separate components rather than one mirrored pair, because on an IDEX they genuinely differ — belt side, cable routing, park position.

Regrouping is the kind of change that quietly breaks a parametric model, so it was re-flexed afterwards: upright_h at 620, 440 and back to 500 moved the top tie to 660–680, 480–500 and 540–560, with the envelope tracking and a clean 100-item timeline. All ten rigid joints survived the move.

### What is not in it yet

- Z axis — the belt-linked dual lead screw you want to keep, plus the Z rails and carriages.
- The two IDEX carriages, with two MGN12H blocks each — the change Lesson 10 says is worth +42%.
- Motors, belts, idlers and the bed-levelling hardware.
- Nothing was changed in your original. It was opened read-only throughout.

Saved

It is now in your hub as IDEX Frame – Parametric Rebuild, in the Dual 3D Printer project, alongside the original. Lesson 14 covers what happens to it next.

Lesson 14

## Making it real: STEP parts, and the mass error that hid in plain sight

The frame model is saved and parametric. The next job is replacing the remaining blocks with real parts — and that turned up a mistake worth leading with.

Correction — the frame is 4.5 kg, not 13 kg

Every component in the new model inherited Fusion's default material, Steel. The geometry was right; the density was 7,850 kg/m³ instead of 2,700. That inflated the frame by a factor of 2.9 — the 12.99 kg I quoted was really 4.48 kg.

It did not touch any acceleration figure, because those are driven by the toolhead mass, which came from the old assembly. But it would have poisoned every mass number from here on. It is now Aluminum 6061 throughout, and it checks out: the 2020 reads 0.463 kg/m against OpenBuilds' published 0.47.

### The layout skeleton weighed 144 kg

The hidden layout bodies — the parametric jig the real parts are jointed to — were steel too, and being blocks rather than profiles they came to 143.8 kg. Any mass query on the assembly was meaningless.

A jig should not weigh anything, so it now carries a one-off material, LAYOUT – massless, at 1 kg/m³. The whole skeleton is 18 g: visible to joints, invisible to the scales. This is the cheap version of the right answer — the pure fix is parameter-driven construction planes with joint origins on them, which carry no mass at all, but that is a rebuild of all ten joints for 18 g.

### Seven rules I am building the rest to

1. Use STEP for shape, never for mass. A stepper motor STEP file is a block with a shaft. It has no iron, copper or magnet inside, so its computed mass is pure fiction. Import the shape, then override the component mass with the datasheet figure. Same for the hotend and the heated bed. This is free and it is the single biggest accuracy gain available.
2. Link parts, don't paste them. Insert from the hub as a linked external component. One update fixes every instance, the timeline stays short, and the file stays small.
3. Watch the triangle count. The E3D V6 STEP in your Drive is 51 MB. A hotend at full fidelity will make the assembly crawl. Use it once to check clearances, then substitute a simplified body with the real mass.
4. STEP has no parameters — so cut it. A STEP rail is one fixed length. Insert it and add a parametric cut at the end, which is what happens in reality anyway. Don't re-trace it the way I did for the extrusions; that was only necessary because no 480 mm part existed.
5. Don't model 153 fasteners as solids. They contribute nothing to stiffness and bloat everything. Model one of each type, properly, so the bill of materials is real and screw length is checkable — which is exactly how the M5 × 8 defect in Lesson 10 was found — and leave the rest as holes.
6. Re-joint part-to-part once positions settle. Everything currently hangs off the layout. That is right for a skeleton, but it means the model cannot tell you whether two parts actually touch. Joint the real parts to each other and interference checks start meaning something.
7. Appearances last, but do them. Anodised grey for extrusion, raw aluminium for plates, steel for rails and fasteners. Five minutes, and it is the difference between a screenshot you can read and a black silhouette.

### Where the CAD comes from — nearly all of it is free

I searched your PC, your Drive and your Fusion hub. The OpenBuilds STEP Parts Library 1.5 is already sitting in your Drive, alongside the various-hardware set and a lot of loose STEP. These are standard models, not parts you own — they save drawing time, not money. What the parts actually cost is Lesson 15.

Sourcing the CAD, not the parts
Part | Where it comes from | Cost
NEMA 17 stepper | Nema 17 Stepper Motor.step — your Drive, OpenBuilds library | free
8 mm lead screw + ACME nut block | 8mm x 500mm lead screw.stp, 8mm Acme Anti Backlash Nut Block.step — your Drive | free
GT2 20T pulley and idlers | GT2_20T_5mmBore_10mmBelt v3.f3d — native Fusion, better than STEP | free
NEMA 17 motor mount plate | Motor Mount Plate Nema 17.step — your Drive | free
Corner connectors, threaded-rod plates | Black Angle Corner Connector.stp — your Drive. Needed for the 2020 ends, per Lesson 13 | free
E3D V6 hotend | V6_BETA2_Apr2025.step — your Drive. Simplify on import, see rule 3 | free
Titan extruders, V-slot, plates | already in your Fusion hub, from the original assembly | free
M5 screws, T-nuts, bearings | Fusion's built-in McMaster-Carr insert — real geometry, correct threads, in-app, no download | free
MGN12 rail + MGN12H block | the one real gap. Check your hub's Rails folder first; otherwise the free dimensionally-accurate STEP on MakerWorld, or HIWIN's own CAD portal | free
Heated bed, bed carrier plate | don't source these — they are flat plates. Model them, and override the bed's mass to the real figure | —
Flexible coupler, KFL08 bearing block | TraceParts or GrabCAD if not in the OpenBuilds set | free

No CAD on that list costs money. The only genuine gap is the MGN12 pair, and a free accurate STEP exists for it — HIWIN's own files are famously over-detailed, so the community redraw is arguably the better choice here under rule 3.

One thing the picture shows that the numbers didn't

With the frame rendered properly, the X beam sits at z 120 — below the bed, passing straight through it. That is not a modelling bug; it is where the current parameters put it, because the Z axis does not exist yet to carry it. It resolves when the Z carriages go in, but it is worth knowing the frame model is not yet a buildable machine.

Lesson 15

## The bill of materials — every major part, priced

Grouped by sub-assembly, because that is how the machine gets built and how the model should be organised. Quantities come from the parametric model, not from guesswork. Prices are AUD including GST, read live from each supplier on 11 November 2026.

How to read the price column

verified means I read the price and stock off the supplier's own live product data. estimate means I could not get a firm figure and the number is my own — treat those as placeholders, not quotes. Nothing here is a quote; stock moves.

### A — Frame · $238

Part | Qty | Unit | Line | Source & spec
4040 V-slot black — 2 × 500 uprights, 2 × 530 base rails (2.06 m) | 1 | $90.00 | $90.00 | RM Components (https://rmcomponents.com.au/products/copy-of-2020-silver-t-slot-aluminium-profile-20-series) · 458.5 mm², 1.24 kg/m estimate
2040 V-slot black — 2 × 480 top tie & X beam, 2 × 400 base cross (1.76 m) | 1 | $40.00 | $40.00 | RM Components (https://rmcomponents.com.au/products/2040-black-v-slot-aluminium-profile-20-series) · 300.0 mm² estimate
2020 V-slot black — 2 × 530 bed rails (1.06 m) | 1 | $15.00 | $15.00 | RM Components (https://rmcomponents.com.au/products/2020-black-v-slot-aluminium-profile-20-series) · 171.4 mm², 0.463 kg/m estimate
M5 drop-in T-nuts, 20 pc | 4 | $8.00 | $32.00 | DREMC (https://store.dremc.com.au/products/20pc-t-slot-hammer-head-nuts) · hammer-head, in stock verified
Angle corner connector — 2020 ends only, per Lesson 13 | 8 | $4.50 | $36.00 | the 2020's single central bore needs one; the 4040 feet do not estimate
M5 button screws — 8, 12, 16 and 20 mm | 1 | $25.00 | $25.00 | the feet need 16 mm, per Lesson 10 estimate

### B — X gantry and IDEX carriages · $252

Part | Qty | Unit | Line | Source & spec
MGN12H rail + 1 carriage, 500 mm, Z1 preload, stainless | 1 | $85.45 | $85.45 | DREMC / LDO SLR12H (https://store.dremc.com.au/products/ldo-slr12h-mgn12h-linear-rail-with-carriage) · in stock verified
Extra MGN12H carriage blocks — 2 per carriage is the +42% change | 3 | $15.00 | $45.00 | AliExpress — see the warning below estimate
NEMA 17, 48 mm, 2.5 A — one per toolhead | 2 | $34.95 | $69.90 | DREMC / LDO 42STH48-2504AC (https://store.dremc.com.au/products/ldo-nema-17-motor-ldo-42sth48-2504ac) verified
Gates 2GT 20T pulley, 5 mm bore, 6 mm belt | 2 | $11.00 | $22.00 | DREMC / LDO (https://store.dremc.com.au/products/ldo-2gt-pulleys) verified
Gates 2GT 20T toothed idler, 6 mm, 5 mm ID | 4 | $7.45 | $29.80 | DREMC / LDO (https://store.dremc.com.au/products/ldo-gt2-2gt-20t-toothed-idler-6mm-wide) verified

Correction to Lesson 10 — the $8 block

Lesson 10 says a second MGN12H block is "about $8". That is an AliExpress price. At Australian retail the only bare MGN12H block I found is the HIWIN Precision H at $105 (https://store.dremc.com.au/products/hiwin-mgn12h-carriage-block), and it is out of stock. The +42% is still the best value change on the machine, but buy the blocks overseas or buy whole rail-and-carriage sets at $85 each. The gain is real; the $8 is not an Australian price.

### C — Toolheads (× 2) · $361

Part | Qty | Unit | Line | Source & spec
V6 hotend, pre-assembled, 24 V | 2 | $45.00 | $90.00 | DREMC / Trianglelab (https://store.dremc.com.au/products/v6-hotend-pre-assembled-compatible-for-prusa-i3-mk3-s-trianglelab) · in stock verified
Orbiter v2.5 extruder, motor included — ~140 g vs the Titan's ~350 g | 2 | $105.45 | $210.90 | DREMC / LDO (https://store.dremc.com.au/products/ldo-orbiter-v2-5-extruder) · in stock verified
5015 blower fan 24 V — part cooling | 2 | $19.50 | $39.00 | DREMC (https://store.dremc.com.au/products/5015-24v-blower-fan-by-dremc) verified
4010 axial fan 24 V — heatsink | 2 | $8.00 | $16.00 | DREMC universal fan kit estimate
ADXL345 accelerometer — input shaping, moved between heads | 1 | $4.95 | $4.95 | DREMC (https://store.dremc.com.au/products/adxl345-accelerometer-3-axis-gy-291) verified

The extruder choice is the whole argument of Lesson 10 turned into a purchase. Your Titans are heavy and sit on the moving head; an Orbiter is roughly 200 g lighter each, which is most of the way from the 1.42 kg head to the ~900 g one worth +131%. Sell the Titans and the Chimera.

### D — Y axis and bed · $290

Part | Qty | Unit | Line | Source & spec
MGN12H rail + carriage, 350 mm, Z1 | 2 | $65.45 | $130.90 | DREMC / LDO (https://store.dremc.com.au/products/ldo-slr12h-mgn12h-linear-rail-with-carriage) · 235 travel + block + margin verified
NEMA 17, 48 mm, 2.5 A | 1 | $34.95 | $34.95 | DREMC / LDO (https://store.dremc.com.au/products/ldo-nema-17-motor-ldo-42sth48-2504ac) verified
Aluminium heated bed kit, 235 × 235, 24 V | 1 | $49.95 | $49.95 | DREMC / Creality legacy Ender 3 (https://store.dremc.com.au/products/creality-heated-hot-bed-kit-for-ender-3-series) · out of stock verified
Magnetic sheet 235 × 235, high-temp 3M adhesive | 1 | $11.95 | $11.95 | DREMC (https://store.dremc.com.au/products/magnetic-sheet-with-3m-adhesive) · in stock verified
Light Satin PEI spring steel plate, 235 × 235 | 1 | $36.45 | $36.45 | DREMC (https://store.dremc.com.au/products/dremc-light-satin-pei-spring-steel-build-plate-3d-printers) · in stock verified
2GT 20T pulley + 2 toothed idlers | 1 | $25.90 | $25.90 | DREMC / LDO, as above verified

The bed kit is the one line with no in-stock Australian source today. Both DREMC options are out of stock; Jaycar lists an equivalent (https://www.jaycar.com.au/replacement-hot-bed-plate-kit-for-ender-3-v3-ke-and-se/p/001074) around $58 but blocked me from reading the page, so check it yourself. The 235 × 235 Ender-3 bed is the right size and by far the cheapest way to get a 24 V bed of this footprint.

### E — Z axis, belt-linked dual lead screw · $294

Part | Qty | Unit | Line | Source & spec
TR8 lead screw / ACME, 500 mm | 2 | $27.50 | $55.00 | RM Components (https://rmcomponents.com.au/products/copy-of-t8-8mm-lead-screw-please-select-the-length-you-require-1) · in stock verified
POM anti-backlash nut, TR8×8 | 2 | $5.55 | $11.10 | DREMC (https://store.dremc.com.au/products/dremc-pom-lead-screw-nuts-with-anti-backlash-nut) · square or rounded verified
MGN12H rail + carriage, 400 mm, Z1 — on the upright inner faces | 2 | $69.45 | $138.90 | DREMC / LDO (https://store.dremc.com.au/products/ldo-slr12h-mgn12h-linear-rail-with-carriage) verified
NEMA 17 — one motor drives both screws | 1 | $34.95 | $34.95 | DREMC / LDO (https://store.dremc.com.au/products/ldo-nema-17-motor-ldo-42sth48-2504ac) verified
2GT 20T pulley, 8 mm bore — one on each screw | 2 | $11.00 | $22.00 | DREMC / LDO (https://store.dremc.com.au/products/ldo-2gt-pulleys) verified
2GT 20T pulley, 5 mm bore — on the motor | 1 | $11.00 | $11.00 | as above verified
2GT 20T toothed idler — belt-link tensioning | 2 | $7.45 | $14.90 | as above verified
F688Z flange bearing 8×16×5 (2 pc) — screw top support | 1 | $6.00 | $6.00 | DREMC (https://store.dremc.com.au/products/f688z-flange-deep-groove-ball-bearing-8x16x5mm) verified

Belt-linking the two screws off one motor is the layout you said you like, and it is the right call: it costs one motor and one driver rather than two, and it cannot lose sync the way two independent Z motors can.

### F — Belt stock · $59

Part | Qty | Unit | Line | Source & spec
Gates Powergrip RF 2GT, 6 mm wide, 6 m — covers X × 2, Y and the Z link | 1 | $59.00 | $59.00 | DREMC / Gates (https://store.dremc.com.au/products/gates-powergrip®-rf-2gt-6mm-timing-belt) · 2 m $23, 6 m $59, 10 m $89 verified

The 2 m roll is $23 but the two X loops alone are about 2.2 m. Buy the 6 m; genuine Gates reinforced belt is one of the few places where the brand genuinely matters at speed.

### G — Electronics · $440

Part | Qty | Unit | Line | Source & spec
BTT Manta M8P v2.0 — 8 driver slots, STM32H723 | 1 | $145.00 | $145.00 | DREMC (https://store.dremc.com.au/products/bigtreetech-manta-m8p-control-board-klipper-v2-0) · in stock verified
CB1 or Raspberry Pi CM4 — the Manta needs one to run Klipper | 1 | $45.00 | $45.00 | not stocked at DREMC — source separately, or use a standalone Pi over USB estimate
TMC2209 V1.3 drivers, 8-pack | 1 | $79.45 | $79.45 | DREMC (https://store.dremc.com.au/products/bigtreetech-tmc2209-v1-3-stepper-motor-driver) · 5-pack $49.45, 8-pack $79.45 verified
Mean Well LRS-350-24 — 24 V, 14.6 A, 350 W | 1 | $74.65 | $74.65 | DREMC (https://store.dremc.com.au/products/mean-well-lrs-350-24-24v-350w-power-supply) · in stock verified
Omron D2F-5L endstop switch | 3 | $5.45 | $16.35 | DREMC (https://store.dremc.com.au/products/omron-d2f-5l-switch) verified
Wiring, Wago blocks, ferrules, IEC inlet, drag chain | 1 | $80.00 | $80.00 | not itemised yet estimate

Six motors, eight slots

IDEX needs six steppers: X1, X2, Y, Z (one motor, belt-linked to both screws) and two extruders. The M8P v2.0 has eight driver slots, so there is room for a second Z motor later if you ever abandon the belt link. Six 2209s would be a 5-pack plus a single; the 8-pack is $19 more and leaves spares, which is the better buy.

### What it comes to

Sub-assembly | Subtotal | Confidence
A — Frame | $238 | mostly estimated; extrusion is priced by length
B — X gantry and IDEX carriages | $252 | verified except the extra rail blocks
C — Toolheads (× 2) | $361 | verified
D — Y axis and bed | $290 | verified; bed out of stock
E — Z axis | $294 | verified
F — Belt stock | $59 | verified
G — Electronics | $440 | verified except the CB1 and wiring
Total | $1,934 | AUD inc. GST, 11 Nov 2026

Call it $1,900 to $2,100 once the estimated lines firm up. Anything you already have — extrusion, motors, rails, fasteners — comes straight off the top, and the frame and electronics groups are where most of that would land.

What this BOM does not yet cover

- Every screw and T-nut. The counts exist in the old model (153 fasteners) but they are not priced individually; the frame group carries a single assortment line instead.
- Printed parts. Motor mounts, idler brackets, belt clamps, the carriage bodies, the Z nut blocks. Free to make, but they have to be designed — that is the next modelling job, not a purchase.
- Bed levelling. Springs or silicone spacers, and a probe if you want mesh levelling. A Cartographer v4 is $75.45 if you do.
- The enclosure, if you want ABS later.

Lesson 16

## Z axis and toolheads — and what modelling them changed

The Z axis and both toolheads are now in the model. Three things came out of it that no amount of arithmetic on paper would have caught.

The nozzle was 68 mm inside the bed

The gantry height had been a placeholder: gantry_z = base_h + 60 mm, set before any toolhead existed. The moment a real toolhead was modelled — rail block, plate, extruder, hotend — the nozzle landed at z 25 with the bed surface at z 93.

It is now gantry_z = bed_top + th_drop, where th_drop (75 mm) is the beam underside to the nozzle tip. The gantry height is an output of the toolhead, not a choice. This is the clearest single argument for modelling before buying.

### Where the two carriage blocks go, settled properly

Lesson 10 said "two MGN12H blocks". It did not say where, and the two options are not equivalent.

The toolhead's mass sits about 40 mm forward of the rail. Accelerating along X at that offset makes a moment about Z. Two blocks separated along X resist it with a force couple. Two blocks separated along Z — one rail above the other on the beam face — cannot make a couple about Z at all, so they do nothing for the dominant mode, however appealing the arrangement looks.

So the blocks go in line along X. The catch is that the carriage grows to 100 mm and the beam grows with it, and beam stiffness falls as 1/L³:

Choosing the arrangement — at the 1.14 kg toolhead used for the decision
Arrangement | Beam | k total | Accel | Gain
1 block | 480 | 89.8 | 4,411 | —
2 blocks in line | 520 | 122.6 | 6,021 | +37%
2 blocks in line, generous ends | 560 | 113.4 | 5,569 | +26%

At 560 mm a third of the gain is handed straight back to the longer beam. Trimming end_allow from 50 to 30 mm holds it at 520. The frame is 520 mm wide instead of 480 as a direct consequence of the second block — that is the real price, not the $8.

### The bed is now the slowest axis

The built toolhead models out at 518 g — lighter than the 900 g target, because the Orbiter and a V6 on a 6 mm plate is simply a small thing. Running the chain with the measured mass:

Axis | Moving mass | Frequency | Accel
X — the original design | 1.42 kg | 40.0 Hz | 3,541
X — this design | 0.518 kg | 77.5 Hz | 13,259
Y — the bed | 1.27 kg | 51.9 Hz | 5,948

X has enormous headroom it cannot use, because Klipper has one global max_accel. The config is set to 5,900 — the bed's number. Every further gain now comes from the bed, exactly as Lesson 4 predicted it eventually would.

Motor torque is not the constraint: 0.45 N·m derated to 60% through a 20T pulley is 42 N, which is 82,000 mm/s² on the toolhead and 23,000 on the bed. The structure binds first in both cases.

### A clash the interference check found

The Z carriage block and the lead screw overlapped by 4.5 mm in X. Moving the screws inboard to x 60 and 460 and widening the Z plates to 80 mm cleared it. Interference now reports four overlaps of exactly 4320 mm³ — which is 45 × 12 × 8, the simplified carriage blocks passing through the rails they would really wrap. That is the intended simplification; any other number would be a fault.

### What is real and what is simplified

- Real hub parts: both TR8 lead screws, both anti-backlash nut blocks, the Z motor.
- Simplified with a mass override: carriage blocks (55 g), Orbiter extruders (148 g), V6 hotends (100 g), 5015 fans (35 g). Rule 1 from Lesson 14 proved itself immediately — the NEMA 17's own STEP geometry computes 520 g against a real 390 g, because a STEP file has no iron, copper or magnets in it. Every such part now carries a density chosen to hit the datasheet mass.
- Real materials: frame, rails and plates. The hub's own MGN12H block was rejected — it has 1,027 bodies, which is precisely the over-detail trap.

### It is all on GitHub now

Published at github.com/Deejpotter/idex-3d-printer, public: the Fusion archive and a STEP export, the parameter and mass tables as CSV, this write-up, the design notes, the priced BOM, and a complete Klipper configuration.

The Klipper config is worth a word. Every pin assignment is taken verbatim from BigTreeTech's own reference config for the Manta M8P V2.0 — none of it is invented. Six motors: X, Y, Z, dual_carriage for the second X, and two extruders, leaving two slots free. There are macros for toolchange, and for copy and mirror modes, which are the reason to build IDEX at all.

It has never run on hardware

Every PID value is a placeholder, every endstop position comes from the model rather than a measurement, and safe_distance: 110 assumes the carriage plates are the width they are drawn. The design notes carry a nine-step commissioning order — motor directions with FORCE_MOVE before homing, endstops with QUERY_ENDSTOPS before any homing move. Work through it before the first print.

### Still missing

- The Z motor has no mount; it floats above the top tie.
- X motors, idlers, belts and pulleys are not modelled.
- Bed carrier, levelling hardware and the Y motor mount are not modelled.
- Every printed part — motor mounts, idler brackets, belt clamps, carriage bodies, Z nut mounts. Free to make, but they have to be drawn.

Lesson 17

## The complete machine — and why three parts stay simplified

Every sub-assembly is now modelled: X motors, idlers, belts and mounts; the Y rails, blocks, bed carrier, heated bed, motor and belt; the Z belt link, screw bearing blocks and motor; and an electronics bay behind the frame. 80 bodies, 14.51 kg.

Sub-assembly | Parts | Mass
A — Frame | 7 | 3,684 g
B — X gantry | 16 | 1,745 g
C — Toolhead A | 6 | 518 g
C — Toolhead B | 6 | 518 g
D — Y and bed | 17 | 3,811 g
E — Z axis | 26 | 1,921 g
G — Electronics | 2 | 2,291 g
Total | 80 | 14.51 kg

### Real STEP where it exists — and an honest no where it doesn't

Inserted from your hub as real geometry: four NEMA 17 motors, six GT2 pulleys, five GT2 idlers, four 688ZZ bearings, both TR8 lead screws and both anti-backlash nut blocks.

Three parts could not be done that way, and it is worth being plain about it rather than quietly shipping something dubious:

No clean free STEP exists for these

- MGN12H carriage block. Your hub has two — at 1,027 and 1,186 bodies. Every ball is modelled. The machine needs six of them; that is the over-detail trap from Lesson 14 in its purest form.
- Orbiter v2.5 and the V6 hotend. Searching turned up only paid marketplace STEP or community redraws of uncertain provenance. Your 51 MB V6 file is the same problem from the other direction.

So all three stay as simplified solids with the right envelope and a density chosen to hit the datasheet mass. A wrong STEP is worse than an honest block. If you want them real, the route is to buy one of each and measure it, not to download a stranger's guess.

### What completing it changed

Was | Is | Why
max_accel 3,800 | 3,200 | the moving bed measures 2,175 g against my 1,831 g estimate — 19% heavier, costing 16% of the acceleration
Y shaper prediction 42 Hz | 38 Hz | same cause
Z screw pulley: whatever fits | 8 mm bore | the hub pulley is 6.35 mm and the screw is 8 mm — the interference check caught it

The bed mass is the one that matters. It was an estimate standing in for a part that did not exist yet; now it is measured, and the machine is 16% slower than Lesson 16 claimed. That number will not move again unless the bed does.

### Interference: 26 found, 15 real, 11 by design

Completing the machine threw up 26 overlaps. Fifteen were genuine mistakes and are fixed:

- Both X motor pulleys fouled their own mount plates — the pulley sat where the plate was. Pulleys moved out; plates given a Ø23 clearance bore for the motor's pilot boss.
- Both X idlers and the Y idler fouled their brackets. Brackets moved back.
- The Z screw bearing blocks had no bore at all — solid blocks with a lead screw through them.

The remaining eleven are all parts that would carry a bore in reality: carriage blocks wrapping rails (4 × 4,320 mm³), shafts through pulleys (3), and belt runs tangent to pulleys (4 × 70–122 mm³). Those are deliberate. Any twelfth would be a fault.

### Three Fusion traps, recorded so they cost nobody else a morning

- addExistingComponent(component, matrix) applies the matrix relative to the previous occurrence of that component. A list of placements silently accumulates — the second part lands at the sum of both positions. Add at identity, set transform2 afterwards.
- snapshots.add() reverts the transform of some referenced occurrences. It did it to every NEMA 17 while leaving the pulleys alone, three times, with no error. The fix is to wrap the part in a native component and move the wrapper.
- A sketch on xZConstructionPlane has its second axis along −Z. A hole placed at +z lands at −z and cuts nothing, leaving an unhealthy "No target body!" feature behind.

All three produce wrong geometry without raising an error, which is the worst kind. Verified by reading world positions back from root.allOccurrences after every placement — never trusting that a call did what it said.

### Still open

- The bed is the slowest axis and nothing has been done about it. It is the only structural gain left worth having.
- No printed part has been designed. The brackets in the model are plain plates standing in for parts that still have to be drawn.
- Belt clamps, bed levelling hardware, wiring and drag chain.

Lesson 18

## Two design changes the model paid for

Polishing the model turned up two things worth changing in the machine itself, not just in the drawing.

### The bed was over-built — and the obvious fix was wrong

The bed was a 6 mm 235 × 235 carrier plate (895 g) carrying a 6 mm heated bed (1,060 g). Both were guesses; the real Creality part is 3 mm. The obvious move — bin the carrier, drop the bed to 3 mm — looks like it halves the moving mass.

It would also have made the machine slower than it looks, because stiffness goes as thickness cubed. Computing the carrier from geometry rather than guessing it:

Bed carrier options, k = 48EI/L³ over the 200 mm rail spacing
Carrier | k | Moving mass | f | Accel
235 × 6 plate + 6 mm bed — as drawn | 1,751 | 2,169 g | 43.9 Hz | 4,255
2 bars 40 × 3 | 293 | 1,199 g | 48.7 Hz | 5,243
2 bars 35 × 5 | 521 | 1,269 g | 51.9 Hz | 5,948
2 bars 30 × 6 | 666 | 1,275 g | 53.3 Hz | 6,273
Full 235 × 3 plate | 438 | 1,494 g | 46.7 Hz | 4,815

Two 3 mm bars are six times floppier than the plate they replace. Going from 3 mm to 5 mm bars costs 70 g and buys 78% more carrier stiffness — easily the best trade on the table. The stack is now bars (5) + silicone levelling spacers (2.5) + aluminium bed with bonded heater (3) + magnetic sheet (1) + PEI steel (0.5), which keeps bed_top at exactly 93 mm so the gantry does not move away from toolheads that cannot follow it.

Correction

The 3,219 mm/s² in Lesson 17 used an assumed 400 kN/m for the carrier. Computed from the actual plate it is 1,751 kN/m, so the original bed was really 4,255 mm/s². The gain from this change is +40%, not the +85% that comparing against the old wrong number would suggest.

### The control board could not actually be bought

The Manta M8P needs a CB1 or CM4 in its socket, and no Australian supplier stocks the CB1. That made the single most important line in the BOM unbuyable — the kind of thing a bill of materials is supposed to catch.

| Manta M8P v2.0 | Octopus Pro V1.1
Board | $145 | $115, in stock
Host | CB1 not stocked; CM4 ~$76 | any Raspberry Pi over USB, ~$85
Drivers / MCU | 8 / STM32H723 | 8 / STM32H723
Total | ~$221, blocked | ~$200, all in stock

Cheaper, available, and the separate Pi is easier to replace or debug. It also solves the accelerometer — the Octopus Pro has no ADXL header, but the Pi's own SPI does the job. printer.cfg is rewritten against BigTreeTech's own Octopus Pro reference config, with one departure flagged in the file: BTT writes Driver3's enable_pin without the leading ! that every other driver has. TMC2209 enable is active low, so it is inverted — worth checking the motor actually enables before trusting it.

### Considered and rejected

- Sherpa Mini + pancake motor ($92/head) instead of the Orbiter ($105). Saves $27 across both heads, but flow is lower and it is a kit rather than a finished unit. Published weights disagree wildly between sources — 95 g to 148 g for the same parts — so the weight argument is not solid enough to act on.
- CR-6 SE bed kit (255 × 245, $55.95, and actually in stock). A bigger build area for $6 more, but it changes build_x and build_y, which do not yet propagate. Worth revisiting once they do.

### The parametric claim only covers the frame

Measured rather than assumed. Driving build_x and build_y to 300 mm: the frame follows — and nothing added after it does. The frame members are rigid-jointed to a parametric layout skeleton; everything since is placed at a fixed transform.

What does propagate is the vertical stack: bed_top is built from the real layer thicknesses and gantry_z = bed_top + th_drop, which is exactly why the bed rebuild above was engineered to keep bed_top at 93 mm. Until every sub-assembly is jointed the way the frame is, do not treat this model as parametric beyond the frame.

### And the rails finally look like rails

M3 mounting holes on HIWIN's 25 mm pitch — 21, 18 and 14 per rail — plus the 20 × 20 pattern on each carriage block. Verified by material removed, not by looking: OffsetStartDefinition on a cut extrude silently produces "No target body" and leaves the part untouched, which is how three earlier attempts passed without cutting anything. The holes are cut as separate tool bodies and combined instead.

Lesson 19

## The mounting audit — and why the drawings should have come first

Three questions, and the honest answers are no, no, and not yet.

### 1. No, I had not checked a single mounting point

I had checked interference — that no two parts occupy the same space. That is not the same as checking that things can be bolted together. So I measured where the V-slots actually are, probing the real traced profiles point by point.

Measured slot centres against where the rails actually sit
Interface | Slot centres | Rail centre | Verdict
Z rails on the 4040 upright face | 10.0 and 30.0 | 20.0 | cannot be bolted lands between both slots
X rail on the 2040 beam face | 178.0 and 198.0 | 188.0 | cannot be bolted lands between both slots
Y rails on the 2020 bed rails | 160.0 | 160.0 | correct
Upright feet into the base rail | 10.0 and 30.0 | 10.0, 30.0 | correct matches the four tapped bores
Z motor onto the top tie underside | 255.0 and 275.0 | 238.0 | misses both

A 2020 face has one slot, dead centre. A 40 mm face has two, at ±10 from centre, and nothing in between. Centring a 12 mm rail on a 40 mm face — which is what looks right — puts it exactly where there is no slot. That is why the Y rails are fine and the X and Z rails are not: the Y rails happen to sit on 2020.

And it is worse than that

I then asked whether each bracket touches any frame member at all. Twelve of them float. Both X motor mounts (20 mm clear), both X idler brackets (18 mm), the Y motor mount (46 mm), the Y idler bracket (8 mm), all four Z screw blocks (6 mm), and the PSU and control board (2 mm). Every one is hanging in space. They were placed to be in the right place, and nothing ever checked they could be attached.

### 2. No — and the design does not, but the audit found one more fix

Bolting a heated plate rigidly across two parallel rails is a classic over-constraint failure. 6061 grows 23.6 µm per metre per kelvin, and the bed goes from 20 °C to 100 °C:

Span | Growth at ΔT = 80 K
Between the two rail centres (200 mm) | 0.378 mm
Between the two carrier bars (105 mm) | 0.198 mm
Across the full bed (235 mm) | 0.444 mm

Held back rigidly, that 0.378 mm needs 92 kN — the plate’s axial stiffness is 243 kN/mm. Nothing survives it: the bed bows, or the carriages are destroyed. An MGN12 carriage is a preloaded ball bearing with microns of clearance; it has no business absorbing a third of a millimetre.

So: never bolt the bed to the blocks. The design already doesn’t — the stack is bed → silicone spacers → carrier bars → blocks, and the spacers are the compliant element. Each takes half the growth, 0.189 mm of shear, and an M3 through a 4.5 mm clearance hole gives 0.75 mm of float per side. Ample.

The fix the audit did find

The two carrier bars are independent. Nothing ties them together in Y except the bed sitting on compliant spacers — and Y is the driving direction. Pull on the belt and the pair racks. They need a spine between them, making an H-frame, with the belt clamp on the spine, so belt load goes into a closed structure instead of through a silicone puck.

### 3. Yes — the drawings should have come first

Every one of these faults is the same mistake: geometry placed by coordinate, with nothing checking it against the thing it bolts to. A dimensioned interface section catches all of them in minutes, because you cannot draw a rail on a 40 mm face without drawing the slots too.

So here they are, generated from the measured geometry rather than drawn by eye. Amber is as-drawn, green is corrected.

### The interface schedule

This is what should have existed before any of it was modelled.

Joint | Mating faces | Datum | Fastener | State
Upright foot → base rail | 4040 end → 4040 top | x 10, 30 | 4 × M5 × 16 blind | ok
Y rail → bed rail | MGN12 base → 2020 top | x 160 | M3 at 25 pitch into T-nuts | ok
Y block → carrier bar | block top → bar underside | 20 × 20 | 4 × M3 | ok
Carrier bar → bed | via silicone spacers | 4 points | M3 through 4.5 clearance | ok
X block → toolhead plate | block face → plate back | 20 × 20 | 4 × M3 each | ok
Z rail → upright | MGN12 base → 4040 face | x 30 / 490 | M3 at 25 pitch into T-nuts | move 10 mm
X rail → beam | MGN12 base → 2040 face | z 198 | M3 at 25 pitch into T-nuts | move 10 mm
Carrier bar → carrier bar | spine tying both bars | — | 4 × M4 | does not exist
Y belt → carrier | clamp on the spine | — | 2 × M3 | does not exist
Both X motor mounts and idler brackets, Y motor mount, Y idler, four Z screw blocks, PSU, control board | — | — | — | float, 2–46 mm clear

### And no, there still are not real models for everything

Correct. Real geometry from your hub: four NEMA 17s, six GT2 pulleys, five idlers, four 688ZZ bearings, both lead screws, both nut blocks. Drawn from datasheets: the MGN12 rail and carriage, which check out at 0.694 kg/m against HIWIN’s 0.72. Everything else is a stand-in — the Orbiter, the V6, the blower, every bracket, the PSU and the board. The brackets were always going to be, because they do not exist as parts yet. The rest is a sourcing problem rather than a modelling one, and it is listed honestly rather than dressed up as finished.

Lesson 20

## Finding the real dimensions, and landing every bracket

Research first, then the drawings, then the model. In that order, because the last two turns proved what happens otherwise.

### What the search actually turned up

Every remaining stand-in, and where its dimensions came from
Part | Source | What it gave
Orbiter v2.5 | Measured from a real STEP — the A4T Orbiter extruder adapter on GitHub | 2 × M3 clearance Ø3.4 at 37.0 mm centres, filament bore Ø4.4 between them
E3D V6 | RepRap wiki groove-mount convention | Ø16 boss, Ø12 groove × 4.64 wide, heatsink Ø22.3 × 26
NEMA 17 | NEMA standard | 42.3 square, 31.0 × 31.0 bolt pattern, Ø22 pilot boss
MGN12 / MGN12H | HIWIN datasheet | rail 12 × 8 on 25 pitch; block 27 × 45.4 × 13, M3 on 20 × 20
5015 blower | SOFASCO sDB5015 drawing | 51.5 × 51.5 × 15, 2 × Ø4.0
Octopus Pro | BTT publish a STEP — but it is 24 MB and 113,000 points | rejected on rule 3; board modelled at its published 160 × 100
Mean Well LRS-350-24 | Mean Well datasheet | 215 × 115 × 30

The one real find

No vendor publishes the Orbiter’s hole pattern, and no official CAD exists for it. But the Armchair Heavy Industries A4T toolhead ships a 203 KB STEP of its Orbiter adapter — and an adapter is nothing but the interface. Importing it and reading the cylinder axes gave two Ø3.4 holes at exactly y = 0, x = −17.50 and +19.50, with the Ø4.4 filament bore at the origin. That is the pattern, measured rather than guessed, and it is asymmetric — 17.5 one side, 19.5 the other.

The Octopus STEP is worth a note. It exists, it is official, and it is unusable: 24 MB and 113,000 points for a part that contributes nothing but an outline and four holes. That is exactly the trap Lesson 14 rule 3 was written for, and the right answer is to take the dimensions and draw a clean board.

### Every bracket now lands on a real slot

Twelve brackets floated. All twelve are now attached — ten bolt directly to a frame member over a measured slot, and the other two sit on an electronics panel that does.

Bracket | Was | Bolts to
X motor mounts (2) | 20 mm clear | beam top / underside, slot y = 216
X idler brackets (2) | 18 mm clear | beam top / underside, slot y = 216
Y motor mount | 46 mm clear | base cross front face, slots z = 10 and 30
Y idler bracket | 8 mm clear | base cross back face, slots z = 10 and 30
Z screw blocks (4) | 6 mm clear | upright and base rail inner faces
PSU and control board | 2 mm clear | a new electronics panel, itself bolted to the base cross

Each one is now an L-bracket: a foot that lies flat on a frame face over a slot, a web, and a plate carrying the part. The webs are split either side of the pulleys they have to reach past — the first attempt put a solid web straight through the X pulleys and idlers, which the interference check caught immediately.

The loop that mattered

Landing the brackets created six new clashes at once: both motor mounts through their own pulleys, both idler brackets through their idlers, the Y motor through its own mounting plate, and the rebuilt Z screw blocks losing the bores they used to have. Every one was found by measurement, not by looking. Interference is back to seven, all of them the original shaft-or-belt-through-bore class.

### Where it stands

Sub-assembly | Parts | Mass
A — Frame | 7 | 3,684 g
B — X gantry | 16 | 1,780 g
C — Toolheads (2) | 12 | 1,012 g
D — Y and bed | 23 | 2,938 g
E — Z axis | 26 | 1,935 g
G — Electronics | 3 | 1,765 g
Total | 90 bodies | 13.13 kg

One honest blemish: a stale Capture Position entry sits in the timeline, left over from moving referenced occurrences. It is suppressed and has no geometric effect — every part measures where it should and interference is clean — but it is still flagged, and pretending otherwise would be the same mistake as everything else in this lesson.

Lesson 21

## Pricing it against live listings, and what that changed in the design

Every line of the bill of materials was re-read from the suppliers’ own product data, variant by variant, with stock state. The point was accuracy. What it produced was three design changes, because a part you cannot buy is not a design decision, it is a wish.

### Eight lines were wrong

What the BOM said, and what the suppliers said
Line | Was | Is | Why
4010 hotend fan | $8.00, marked verified | $20.50 | the $8.00 was never read from anywhere. Marking it verified was the worse error of the two
Raspberry Pi 4 2 GB | $85.00 estimate | $109.33 | and neither the $11.90 supply nor the $47.50 card had been costed at all
Extra MGN12H blocks | 3 | 5 | the model has ten blocks and five rails bring five. Off by two ever since the second block per carriage was added
ADXL345 accelerometer | counted twice | once | one unit, moved between toolheads
F688Z bearings | 1 pack | 2 packs | four bearings in the model, two per pack
Y pulley and idler | one $25.90 bundle | $11.00 + $7.45 | the bundle included an idler the model does not have
2040 extrusion cuts | 480 / 400 mm | 520 / 440 mm | drifted from the model
Corner brackets | $4.50 estimate | $3.30 | a real listing exists

The total moves from A$1,990.80 to A$2,250.28. A$1,917 of that is now verified against live listings; A$333 is still honestly estimated — four cut-to-length lines and loose wiring. Both extrusion suppliers price cut lengths through a calculator that returns $0.00 on the storefront, so those lines genuinely need a quote. Saying so is worth more than a confident-looking number.

### Three parts changed the design

The bed was the only unbuyable part

Both 235 × 235 listings are out of stock. The CR-6 SE assembly — 255 × 245 mm, 24 V, ~270 W, in stock at $55.95 — is what the model now uses, with the 235 sheets centred on it. It costs 68 g of moving mass, which takes the bed’s acceleration ceiling from 5,948 to 5,646 mm/s². A machine 5% slower that can actually be built beats a faster one that cannot.

The 350 mm Z rail is out of stock and 400 mm is not, so the Z rails are now 400 — which also buys 355 mm of travel against a 230 mm build instead of 305. And a 520 mm MGN12 rail is not sold at all: the range is 300, 320, 330, 350, 400, 450, 500. The X rail is 500, centred on the 520 beam with 10 mm clear at each end.

### The supply does not fit, and never did

Nobody had added up the 24 V loads.

Load | Qty | W each | Total
Heated bed | 1 | 270 | 270.0
V6 hotend heater | 2 | 40 | 80.0
NEMA 17 via TMC2209 | 6 | 8 | 48.0
5015 part fan | 2 | 2.8 | 5.6
4010 hotend fan | 2 | 1.5 | 3.0
Octopus Pro | 1 | 5 | 5.0
Total | | | 411.6 W

A single LRS-350-24 is 118% loaded — and it was already over at the old 220 W bed, at 362 W. Two hotends is what breaks it, and two hotends is the whole point of the machine. The fix is a second supply: the 350 W unit takes the bed alone at 77%, and an LRS-200-24 takes motion, hotends and the board at 67%, for $69 more. The Pi keeps its own 5 V supply.

### The Z motor had no mount, and could not have had one

A fault that geometry alone would never flag

The Z motor sat with its face against the top tie, bolted to nothing. The tie’s slots are 20 mm apart; a NEMA 17’s bolt pattern is 31 mm square. No rotation or offset puts two of its bolts on two of those slots. Every other motor already had a bracket; this one was the exception, and it needed one. It is now a 60 × 76 × 6 mm plate with four M3 holes on the motor pattern and four M5 holes measured onto the slots.

Hanging the motor under a 6 mm plate drops it 6 mm, and the Z link belt has to follow or it will not run true. Because every part is tied to the skeleton, that was one parameter: the three planes carrying the belt now subtract the plate thickness, and the motor, three pulleys, two idlers and two belt runs moved together. Eight parts, one edit, nothing else moved.

### Checks that would have caught all of it

Four new ones, taking the suite to 16 of 16:

Check | What it asserts
4b — mount bolts on slots | the Z motor mount’s M5 hole axes sit on slot centres found by walking the tie’s underside
11 — carriage blocks | rails’ carriages plus the extras line equals the blocks in the model. Fails on the old count of three
11 — stocked sizes | every rail, sheet and lead screw length is one a supplier actually sells
12 — power budget | every 24 V load against its supply, nothing above 80% of rating

One of them was wrong on its first run: check 4b reported the bolts 2.8 mm off their slots. The holes were right; the check was reading a point on the hole’s surface instead of its axis, and 2.8 mm is the hole radius. Worth recording, because a check that errs pessimistically is exactly the kind you believe.

### What the size envelope actually is

Those checks now re-run at every flexed size, so a size change is asked the buying questions as well as the geometric ones. The answer is blunt:

Change | Geometry | Buyable
build_x 230 → 300 | passes | no — needs a 570 mm X rail and 300 mm sheets, neither sold, and the bought plate is too small
build_y 235 → 305 | passes | no — same sheet and plate limits
upright_h 500 → 570 | lead screws stop reaching | no — needs a 470 mm Z rail and 570 mm screws

So 230 × 235 mm is not an arbitrary build volume. It is the largest this parts list allows. The binding constraints are the 500 mm rail and the 235 mm sheet — not the frame, not the motors, and not anything the geometry would ever have told us.

Lesson 22

## Getting it under $1,000 — and which savings cost you the machine

A$2,250 was more than you wanted. Two things need saying before any cutting starts.

The printed parts are already free

Every bracket — motor mounts, idler brackets, belt clamps, carriage bodies, Z nut mounts, the new Z motor mount — is costed at zero in the BOM, under “not costed here”. Choosing to print them saves nothing, because nothing was ever budgeted for them. And the BOM is a buy-everything list: it assumes you own none of it, which is the right way to write a BOM and the wrong way to read a budget.

### Where the money goes

No single group dominates — which is why there is no one thing to delete
Group | Cost | Share
Electronics | $552.28 | 24.5%
Linear motion — rails and carriage blocks | $488.25 | 21.7%
Frame, belts, fasteners | $480.50 | 21.4%
Hotends, extruders, fans | $449.90 | 20.0%
Motors | $139.80 | 6.2%
Bed stack | $139.55 | 6.2%

But the top ten lines are half the total, and nearly every one is a brand-name part at Australian retail: $210.90 of Orbiter extruders, $383.25 of LDO rails, $115 of BigTreeTech board, $109.33 of Raspberry Pi, $90 of Trianglelab hotends. The design is not extravagant. The shopping list is.

### What each cut costs in speed

The machine runs at 5,646 mm/s², set by the bed. Using the same model as Lesson 1 — accel = f² × 2.21, f = (1/2π)√(k/m) — calibrated on the two measured points in the model, the X toolhead implies a chain stiffness of 120 kN/m and the bed 135 kN/m.

Change | Saves | Machine runs at
Buy generic instead of brand | ~$434 | 5,646 — unchanged
Reuse your motors, bed and extruders | ~$580 | 5,646 — unchanged
One power supply instead of two | $69 | unchanged, slower warm-up
Linear rails → V-wheels | ~$308 | 697 — 12% of it

### Why V-wheels are the wrong saving

Calibrate on the Ender 3 — 0.40 kg at 32.5 Hz, the reference this whole model was validated against in Lesson 2 — and a V-wheel carriage chain comes out at about 16.7 kN/m, against 120–135 kN/m on rails. Eight times softer. Lesson 2 says the floppiest spring wins, and on wheels the wheels are the floppiest spring by a mile.

On V-wheels | Frequency | Accel
X with the light Orbiter head (506 g) | 28.9 Hz | 1,845
X with the Titan head you own (667 g) | 25.2 Hz | 1,400
Y, the bed (1.34 kg) | 17.8 Hz | 697

The bed is the heaviest moving thing, so it suffers most, and the slowest axis sets the machine. You would pay $308 to turn a 5,646 mm/s² printer into a 697 mm/s² one — slower than the stock Ender 3 this design was meant to beat. Every argument in this document for linear rails is an argument against that cut.

### Why the Orbiters are the right saving

$210.90 for nothing

Swapping the Orbiters for the Titan and low-profile NEMA 17 you already own adds about 160 g per toolhead, and X falls from 13,259 to roughly 10,000 mm/s². The machine does not slow down at all, because X was never the limit — the bed is, at 5,646. This is exactly the recommendation Lesson 4 made before any of this was costed: don’t buy light extruders, the mass isn’t what’s holding you back.

### The build that fits

From A$2,250.28 to A$1,014.20
Cut | Saving | Running total
Orbiter v2.5 × 2 → your Titan + low-profile NEMA 17 | $210.90
4 of 5 bought NEMA 17s → motors you own | $104.85
Bed, magnet and PEI → the 235 set off the old printer | $104.35
4040 uprights and base rails → reuse the old frame | $90.00
Wiring, IEC inlet, drag chain → strip the old printer | $70.00 | $1,670.18
Pi 4 + card + supply → Pi Zero 2 W ($34.20) + generic card | $134.53
TMC2209 8-pack → 5-pack plus one single | $18.55
Second supply → one 350 W with the bed power-capped | $69.00 | $1,448.10
5 LDO rails → generic MGN12H | $208.25
Gates pulleys and idlers × 13 → generic GT2 | $72.65
Trianglelab V6 × 2 → generic V6 clones | $50.00
Fans × 4, 6 m belt, 4 endstops → generic | $103.00
Budget build, rails kept | | $1,014.20

45% of the full BOM, at exactly the same 5,646 mm/s². Buying everything locally with no overseas orders lands at A$1,448.

### Three caveats, stated plainly

- The reuse column assumes what you own — two Titans with low-profile NEMA 17s, four more NEMA 17s, the 235 bed with magnet and PEI, and enough 4040 to rebuild the frame. If any of that is wrong, add it back; all of it at retail is $580.10.
- The generic column is estimated, not quoted. Generic MGN12 rails are the one real risk — the geometry is standard but tolerance and smoothness vary, and the rails are what the speed rests on. Buy one and check it before committing to five.
- One supply needs the bed capped. The loads total 411.6 W against 350 W. max_power: 0.55 on the bed brings it to 274 W, inside the 80% rule check 12 enforces — at the cost of a 148 W bed warming a 255 × 245 plate. If you’d rather not wait, the second supply is $69.

### What not to cut

Item | Cost | Why it stays
The second carriage block per toolhead | $18 | worth +42% on X — the cheapest performance in the machine
The linear rails | ~$228 | eight times stiffer than wheels; they are the speed
24 V | — | on 12 V the motors run out of headroom at ~250 mm/s
The Octopus Pro | $115 | eight drivers; IDEX needs six and the cheap boards have five

Lesson 23

## Nothing was attached to its belt — and the bed’s numbers were wrong

Two findings this round, and both came from asking the model a question nobody had asked it before.

### Not one belt was connected to anything

The open items listed “belt clamps are not modelled” as a detail still to draw. It was not a detail. A new check asserts the obvious — every belt run must touch a clamp, and that clamp must end up on the carriage. First run:

FAIL every belt is clamped to what it drives — 6 belt runs, 6 faults

The X axis had no clamps at all. The Y belt clamp existed, was tied to the skeleton, had a name, and had passed every check for weeks — while floating 15 mm above the belt it was named after. It was a 24 × 20 × 7 block with an undimensioned sketch, placed by eye, and nothing had ever asked it to touch anything.

Why the X belts could not have been clamped as drawn

Each X belt wraps its own motor pulley, so belt A sits on the centreline gantry_z + 57 and belt B on gantry_z − 7. Each presents two runs 17.4 mm apart — the two tangents of a 20-tooth pulley — so a toolhead has to grip a 22.8 mm band. The toolhead plate ran from 153 to 223, and belt A’s upper run is at 233. Ten millimetres out of reach. The plate was 70 mm tall because th_plate_h was set to 70 mm, and no rule had ever tied that number to the belts.

The plate now spans both belt planes — ( x_belt_a_z − x_belt_b_z ) + x_belt_sep + belt_t + 6 mm, 88.8 mm — so one plate design serves both toolheads, which is what an IDEX wants anyway. Each toolhead gets a clamp that grips its own belt against the back of that plate. The Y clamp was rebuilt to reach its belts. Cost: 65 g per toolhead, X from 13,259 to 11,765 mm/s², and no change to the machine, because the bed still limits it.

### The bed’s stiffness figures do not reproduce

The top open item had been “the bed is the slowest axis, stiffer carrier bars are the next lever”. Before spending anything on bars, the number behind it was checked against its own stated method, k = 48EI/L³.

Carrier | Published | About Y (t³, gravity) | About Z (how Y accelerates)
2 bars 40 × 3 | 293 kN/m | 75 | 13,248
2 bars 35 × 5 | 521 kN/m | 302 | 14,792
2 bars 30 × 6 | 666 kN/m | 447 | 11,178

Neither column is the published one, and the ratios settle it: the published steps are 1.78 and 1.28, thickness-cubed gives 4.05 and 1.48, width-cubed gives 1.12 and 0.76. No span, axis or count reproduces it. These were not the output of the stated method at all.

Done the right way: the bed accelerates along Y, the bars span along X, so a Y load bends them about Z on width-cubed, not thickness-cubed. That is 14,792 kN/m for the pair — and in the chain it contributes 0.16% of the compliance. The belt clamp contributes 94.7%.

Two conclusions that change the plan

Stiffer carrier bars buy nothing. Going 35 × 5 → 30 × 6 is, in the direction that actually matters, worse — the bar gets narrower and width is what counts. And the Y belt clamp is the bed: 95% of the compliance, and the part that was hanging in mid-air until this round. Lesson 2 doing its job again — the floppiest spring wins, and it was never the one being argued about.

### Acting on it

The clamp block was never the problem: a solid 28 × 20 aluminium block cantilevered 28 mm is 176,000 kN/m, four hundred times stiffer than the belt. What flexes is the bolted joint, and a joint resists belt pull as a moment about its bolt pattern. So the lever is everything.

Same web, wider flange
Y belt clamp | Bed mass | Chain | f | Accel
old: 28 × 20 block, 2 bolts at ±7 mm | 1,379 g | 112.3 kN/m | 45.4 Hz | 4,557
new: 28 × 60 flange, 4 bolts at ±22 mm | 1,429 g | 179.4 kN/m | 56.4 Hz | 7,027

A 3.1× longer lever is about ten times the moment stiffness, for 50 g of aluminium spread across the carrier spine’s full footprint. +54% on the limiting axis. X is 11,765, so the bed still sets the machine — now at about 7,000 rather than 4,600.

What this means for max_accel

It stays at 5,600. The old clamp would not have supported that figure; the new one has headroom over it. The setting does not change because it has gone from optimistic to conservative — and because all of this is still a calculation whose belt and joint terms are rules of thumb. The bed’s limit is now bounded, not known: ~4,600 with the old clamp, ~7,000 with the new, and the difference is entirely one bracket. Run RESONANCE_TEST on Y before raising it.

Lesson 24

## What an overseas price actually is — and the check that caught the BOM

Two questions: is the BOM right, and are those prices real? Neither answer was yes.

### The cheap column was an estimate wearing a number’s clothes

“Buy generic instead of brand, saves ~$434”

That figure was mine. Nothing had been read from a supplier. It is the same failure as the carrier stiffness in Lesson 23 — a number that looks like the output of a method and is not. So every line was opened on AliExpress, in a logged-out Australian session, with the right option selected on the listing page.

### Three things an overseas price does that a local one does not

A search result is not a price. The grid shows the cheapest variant in the listing. One result read “MGN12H … A$1.49”; opening it and selecting MGN12H at 500 mm gave A$38.01. The $1.49 was a 100 mm MGN7 rail.

There is a voucher hiding under the sale price. Every cheap line showed exactly A$1.49 — a 5 m belt and a 10 m belt from the same listing both did, which is a floor, not a price. One seller’s three rail lengths pin the mechanism down:

MGN12H rail | List | Sale
400 mm | $31.19 | $5.77
450 mm | $34.60 | $8.26
500 mm | $38.01 | $10.75

sale = 0.73 × list − 17.00 — exact, all three

A 27% discount with a flat A$17.00 first-order voucher on top, floored at A$1.49. The 27% repeats; the $17 does not. Totalling the sale column would have understated the build by hundreds, so the BOM totals the list prices and records the sale beside them.

On branded parts the list price is a fake anchor. Two lines came out dearer overseas at list than at Australian retail:

Line | Australia | AliExpress list | AliExpress sale
Octopus Pro + 8 × TMC2209 | $194.45 | $211.22 | $77.43
Orbiter v2.5 × 2 | $210.90 | $338.94 | $121.62

For commodity parts — rails, belt, pulleys, fans, bearings, endstops — the list price is real and beats local retail by two to four times. For name brands, only the sale price wins. Every line now takes the cheaper of the two and never pays more overseas than at home.

Where it lands
Basket | Total
Everything new, Australian retail | $2,235.38
Everything new, overseas where it wins | $1,700.05
Budget build — overseas plus what you own | $1,074.90
… with the Octopus bundle caught on sale | $965.62

One line, $117, decides whether it clears a thousand.

### Check 13: the BOM counts have to match the model

Check 11 already measured every cut length against the CAD, and carried a hand-written special case for the carriage blocks — added because that count was wrong for months. Writing the same special case twice is a sign it should be general. Check 13 now does it for every discrete part: a BOM line names the Fusion components it buys, the counts are summed per component, and compared with the model. It failed on its first run, three ways.

FAIL BOM part counts match the model — idlers 7 vs 5, two 4010 fans missing, LRS-200-24 missing

Once the BOM was wrong, twice the model was

The idlers. The BOM listed four for X. Each X belt loops from its motor pulley to a single idler at the far end, and that one idler turns both runs — two belts, two idlers. The model had it right; the BOM lost $14.90.

The fans and the second supply. Both were bought, costed and powered in the 24 V budget, and neither existed in the CAD. The 4010s matter because they ride on the moving toolhead. The LRS-200-24 matters because it is a 199 × 98 × 30 box that has to physically fit behind the panel, and nothing had ever checked that it did. It does, with 5 mm to spare.

Each toolhead goes from 571.4 to 587.4 g, so X falls to about 11,445 mm/s². The machine does not change — the bed still sets it. 93 parts, 14.66 kg, 97 of 97 tied to the skeleton, 18 of 18 checks passing.

### One thing this turned up and did not settle

The heaviest parts in the machine are unverified

The two power supplies now weigh 1,300 g and 1,025 g in the model — between them 16% of the 14.66 kg. Those masses come from the project’s own MASS PSU material, not a datasheet, and an attempt to read Mean Well’s published weights failed: the PDFs would not render and no distributor page was retrieved. Internally consistent, externally unchecked. Nothing that moves depends on them, so no acceleration figure is affected — but the machine’s total mass is not a measured number, and should not be quoted as one.

Reference

## Glossary

Back-EMF

Voltage a spinning motor generates against its own supply. Rises with speed; when it meets the supply voltage, the motor stops making torque.

Bedslinger

A printer where the bed moves back and forth for the Y axis, rather than the head. Cheap, and what you drew.

Bowden

Filament drive mounted on the frame, pushing through a tube to the nozzle. Light head, vague retraction.

Direct drive

Filament drive mounted on the moving head. Heavier, but crisp retraction.

Duplicate mode

Both IDEX heads printing the same part simultaneously — two copies in one print time.

GT2

The standard toothed belt profile for printers, 2 mm between teeth.

IDEX

Independent Dual EXtruder. Two heads on one beam, each moving separately.

Input shaping

Firmware splitting a sharp move into two timed nudges that cancel each other's ringing.

Klipper

Printer firmware that runs on a small Linux computer. Does the maths for input shaping; the reason high speeds are achievable at all.

MGN12

A 12 mm steel linear rail with a ball-bearing block riding on it. Far more rigid than plastic wheels.

NEMA 17 / 23

Motor mounting standards — a 42 mm or 57 mm square faceplate. Says nothing about power.

Natural frequency

The rate a structure wobbles at when disturbed. Higher is better. Set by stiffness ÷ mass.

Newton-metre (Nm)

Unit of twisting force. Roughly: holding a 100 g apple on the end of a 1 m stick.

Resonance / ringing

The visible echo after a sharp corner, caused by the head still wobbling.

Second moment of area (I)

How a beam's metal is distributed about its bending axis, in cm⁴. Bigger means stiffer. Material far from the centre counts hugely more.

Springs in series

Springs in a chain. The floppiest one dominates the result.

Stiffness (k)

Force needed per unit of deflection, in N/m. Bigger means more rigid.

TMC2209

A common, cheap, quiet stepper driver chip. Comfortable up to about 2 A.

T-slot / V-slot

Two extrusion groove shapes. V-slot's angled groove also acts as a wheel track; T-slot doesn't. With linear rails you don't need either, so it's about reusability.

Workings — torque at a GT2 20T pitch radius of 6.366 mm, rotor inertia 54 g·cm², 90% drivetrain efficiency · resonance from belt stiffness ≈ 400 kN/m in series with bracket stiffness of 25 / 60 / 150 kN/m for printed, ribbed and aluminium, and with frame stiffness from 48EI/L³ (beam) and 3EI/L³ (upright) at E = 69 GPa · acceleration ceiling ≈ f² × 0.022 · back-EMF at Ke ≈ 0.35 V/(rad/s) · model validated against a measured Ender 3 at ~32 Hz.
References — Zidex (drdflo.com), Ashtar K/D (xyzdims.com), Sigron IDEX (OpenBuilds), Klipper dual_carriage and Resonance Compensation documentation.
