Deejpotter/idex-3d-printer/(commit log)

2026-11-10 IDEX 3D printer: parametric model, analysis, BOM and Klipper config
    Initial publication of the design.
    Model (Fusion, exported to cad/):
    - 38 driving parameters; lengths and positions both follow them, held by
    rigid joints to a grounded layout skeleton.
    - Real V-slot cross-sections traced from the actual profiles.
    - Z axis: two TR8x8 screws belt-linked to one motor, MGN12 rails on the
    upright front faces.
    - Two IDEX toolheads, 518 g each, two MGN12H blocks apiece.
    Analysis (docs/design-notes.md):
    - The toolhead, not the frame, was the original speed limit. With Orbiter
    extruders and two blocks per carriage, X models at ~13,200 mm/s2 and the
    bed becomes the slowest axis at ~3,800.
    -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
    [idex-frame-assembly.f3d, idex-frame-assembly.step, idex-macros.cfg, mass-report.csv, parameters.csv, printer.cfg]
2026-11-10 docs: add Lesson 16 - Z axis and toolheads
2026-11-10 Complete the machine: X, Y, Z drives, bed and electronics
    Every sub-assembly is now modelled - 80 bodies, 14.51 kg.
    Real parts inserted from the Fusion hub: 4 NEMA 17 motors, 6 GT2 pulleys,
    5 GT2 idlers, 4 688ZZ bearings, 2 TR8 lead screws, 2 anti-backlash nut
    blocks. No clean free STEP exists for the MGN12H block, the Orbiter or the
    V6, so those stay as simplified solids with datasheet mass - the hub's own
    MGN12H models are 1027 and 1186 bodies.
    Corrections the completed model forced:
    - max_accel 3800 -> 3200. The moving bed measures 2175 g against the
    1831 g estimate; 19% heavier costs 16% of the acceleration.
    - Input shaper Y prediction 42 -> 38 Hz.
    - The Z screw pulley needs an 8 mm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
    [idex-frame-assembly.f3d, idex-frame-assembly.step, idex-printer-assembly.f3d, idex-printer-assembly.step, mass-report.csv, printer.cfg]
2026-11-10 Model the rails, blocks and toolhead parts properly
    The MGN rails and carriage blocks were plain rectangular bars. They are now
    drawn from the HIWIN MGN12 datasheet: a 14-point rail section with ball
    grooves and top chamfers, and a C-section block that wraps the rail. The
    rail section computes 0.694 kg/m against HIWIN's published ~0.72.
    That removes the four 4,320 mm3 rail/block interferences - the blocks now
    wrap the rail instead of passing through it. Interference is down to seven,
    all of them a shaft or belt meeting a part that would carry a bore.
    Toolhead parts reshaped: the V6 is nozzle, heater block, heat break, finned
    heatsink and coupling rather than a plain cylinder; the Orbiter i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
    [idex-printer-assembly.f3d, idex-printer-assembly.step, mass-report.csv]
2026-11-10 Rebuild the bed, change the control board, detail the rails
    Bed: it was a 6 mm carrier plate under a 6 mm heated bed, both guessed. The
    real Creality part is 3 mm. Deleting the carrier outright would have been a
    mistake - two thin bars are six times floppier than the plate they replace,
    and stiffness goes as t^3. Computing k = 48EI/L^3 for each option picks
    2 x 35 x 5 mm bars: carrier 521 kN/m at 222 g against 1751 kN/m at 895 g.
    Moving bed mass 2169 -> 1269 g, Y acceleration 4255 -> 5948 mm/s2 (+40%).
    bed_top deliberately stays at 93 mm so the gantry does not move away from
    toolheads that cannot follow it.
    Correction: the 3219 mm/s2 quoted earlier used an assumed 400 kN/m carrier
    stiffness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
    [idex-printer-assembly.f3d, idex-printer-assembly.step, mass-report.csv, parameters.csv, printer.cfg]
2026-11-10 docs: Lesson 18 - the bed rebuild and the board change
2026-11-10 Mounting audit: two rails could not be bolted on, twelve brackets float
    Interference checking says no two parts share space. It says nothing about
    whether they can be fastened together, and nothing had ever checked that.
    Measured the V-slot positions by probing the traced profiles. A 2020 face has
    one slot dead centre; a 40 mm face has two at +/-10 with nothing between. The
    X rail and both Z rails were centred on 40 mm faces - exactly where there is
    no slot. The Y rails were fine only because they sit on 2020. Both rails are
    now on the measured slot centres (x 30/490, z 198), with the carriage blocks
    and belt A moved to suit.
    Then asked whether each bracket touches any frame member. Twelve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
    [idex-printer-assembly.f3d, idex-printer-assembly.step, mass-report.csv]
2026-11-10 Research the real dimensions, then land every bracket on a slot
    Research first, then drawings, then model.
    Orbiter v2.5: no vendor publishes its hole pattern and no official CAD
    exists, but the A4T toolhead ships a 203 KB STEP of its Orbiter adapter -
    and an adapter is nothing but the interface. Imported it and read the
    cylinder axes: 2 x M3 clearance 3.4 dia at 37.0 mm centres, x -17.50 and
    +19.50, both at y 0, with the 4.4 filament bore at the origin. Asymmetric,
    and measured rather than guessed.
    Also pinned down: V6 groove mount (16 boss, 12 groove x 4.64), NEMA 17
    (31 x 31, 22 dia boss), 5015 blower (51.5 sq, 2 x 4.0). BTT do publish an
    official Octopus STEP - 24 MB and 113,000 points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
    [idex-printer-assembly.f3d, idex-printer-assembly.step]
2026-11-10 Replace eyeballing with design-rule checks, and measure the parametric claim
    Checking the model by looking at renders is neither precise nor repeatable,
    and it is how every fault in this project got in. scripts/check_model.py
    asserts the rules numerically instead: nozzle height against bed_top, every
    bracket touching a frame member, rails centred on real V-slots, interference
    limited to the known shaft-through-bore set, timeline health, and toolhead
    parking. 8 of 9 pass - the failure is the suppressed stale Capture Position.
    The check that matters flexes each driving parameter and counts what moved.
    Parameter coverage is 10% for build_x, 12% for build_y and 4% for upright_h.
    So the model is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
2026-11-11 Separate driving parameters from derived, and audit what each one drives
    There is an established pattern for configurable product families, a layer
    above skeletal modelling: the driving values do not live in the CAD. A
    handful of drivers, derived lengths as formulas, validation that runs before
    the model regenerates, and a BOM generated from the same source.
    Audited mine against that. 33 bare numbers against 8 expressions, and twelve
    parameters that drive nothing at all - decoration that reads as design
    intent. Decoration rots: z_screw_x still said 33 mm long after the lead
    screws moved to 60 in the slot-centre fix, so anyone reading the parameter
    list would have believed it.
    Applied: z_sc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
2026-11-11 Skeleton-driven model: every part tied, rules re-checked at other sizes, BOM check line
    - Skeleton component (no solids): parameter-driven planes, anchors and seats;
    all 91 parts rigid-jointed to it; old pasted-body Layout deleted
    - Rail, belt, bed-stack, plate and block lengths driven by parameters
    - X rail 500 mm (longest stocked), centred on the 520 mm beam
    - check_model: check 8 rewritten (tied + rules re-run at flexed sizes),
    check 9 regex fixed (literal backspaces), lead-screw seating check,
    BOM check line (11) against docs/bom.json
    - BOM corrected: rail and 2040 lengths had drifted from the model
    - Stale Capture Position removed; timeline healthy; 14/14 checks pass
    [idex-printer-assembly.f3d, idex-printer-assembly.step, parameters.csv]
2026-11-11 Price every BOM line against live listings; three parts change the design
    BOM, re-read from supplier product data on 11 Nov 2026 variant by variant:
    - every line now carries a link, the option actually priced, and stock state
    - eight lines were wrong. The 4010 fan was $8.00 marked verified (really
    $20.50), the Pi was $85 estimated (really $109.33 plus supply and card),
    extra MGN12H blocks said 3 where the model needs 5, the ADXL345 was counted
    twice, F688Z bearings needed 2 packs not 1, and the Y pulley bundle listed
    an idler the model does not have
    - total A$1,990.80 -> A$2,250.28, of which A$333.20 is still estimated: the
    four cut-to-length lines (no supplier publishes a per-mm r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
    [idex-printer-assembly.f3d, idex-printer-assembly.step, parameters.csv, printer.cfg]
2026-11-11 Add the Z motor mount, the last motor without one
    The Z motor sat against the top tie's underside bolted to nothing, and could
    not have been bolted: the tie's slots are 20 mm apart (y 255 and 275) and a
    NEMA 17 pattern is 31 mm square, so no placement of the motor puts two bolts
    on two slots. Every other motor already had a bracket.
    - new Z motor mount: 60 x 76 x 6 mm plate, four M3 holes on nema_bolt plus a
    23 mm pilot bore for the motor, four M5 holes measured onto the slots. Both
    sketches fully constrained, every hole an expression on frame_d / p40 / p20
    - the plate pushes the motor down z_mount_t, so the three skeleton planes that
    carry the Z belt plane now subtract it: motor, th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
    [idex-printer-assembly.f3d, idex-printer-assembly.step, parameters.csv]
2026-11-11 Build spec lesson 21: live pricing, the power budget, and the parts that changed the design
2026-11-11 Regenerate the mass report; correct the machine mass to the measured 13.42 kg
    [mass-report.csv]
2026-11-11 Cost down to A$1,014 without losing speed; what each cut costs
    Answers 'can it be under $1000'. The money is spread evenly across six groups,
    but the top ten lines are half of it and nearly all of them are name brand at
    Australian retail.
    - printed parts are already free in the BOM - the brackets were never costed
    - reuse (motors, bed, Titan extruders, old frame) saves $580 at no speed cost
    - generic instead of brand saves $434 at no speed cost -> A$1,014 total
    - rails -> V-wheels saves $308 but takes the machine from 5,646 to 697 mm/s2,
    worse than a stock Ender 3: a V-wheel chain is ~16.7 kN/m against 120-135
    on rails, calibrated on the Ender 3 reference the model was validated against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
2026-11-11 Build spec lesson 22: getting under $1,000 and what each cut costs in speed
2026-11-11 Clamp the belts to the carriages, and correct the bed stiffness analysis
    Check 4c asserts that every belt run touches a clamp and that clamp ends up on
    the carriage. First run failed all six runs: the X axis had no belt clamps at
    all, and the Y belt clamp - tied to the skeleton, passing every other check -
    floated 15 mm above the belt it was named after.
    The X belts could not have been clamped as drawn. Each belt wraps its own
    pulley, so belt A sits on gantry_z + 57 and belt B on gantry_z - 7, each
    presenting two runs 17.4 mm apart. The toolhead plate ran 153..223 and belt A's
    upper run is at 233: ten millimetres out of reach.
    - th_plate_h now spans both belt planes, 88.8 mm, one plate for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
    [idex-printer-assembly.f3d, idex-printer-assembly.step, mass-report.csv, parameters.csv, printer.cfg]
2026-11-11 Redesign the Y belt clamp: +54% on the limiting axis for 50 g
    Section 23 found the bed's compliance is 95% belt clamp and 0.16% carrier bar.
    Acting on that: the clamp block is never the problem - a solid 28x20 block
    cantilevered 28 mm is 176,000 kN/m - the bolted joint is, and a joint resists
    belt pull as a moment about its bolt pattern.
    The old clamp was 28x20 with two bolts ~14 mm apart. The new one keeps the web
    down to the belt and adds a 60 mm flange with four bolts at +/-22, spread over
    the carrier spine's full footprint: a 3.1x longer lever, ~10x the moment
    stiffness, for 50 g.
    old 1,379 g 112.3 kN/m 45.4 Hz 4,557 mm/s2
    new 1,429 g 179.4 kN/m 56.4 Hz 7,027 mm/s2
    X is 11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
    [idex-printer-assembly.f3d, idex-printer-assembly.step, mass-report.csv, parameters.csv]
2026-11-11 Build spec lesson 23: the disconnected belts and the bed's unreproducible numbers
2026-11-11 Price every line on AliExpress, and add the check that caught the BOM
    The budget page costed the generic column at "~$434, estimated". That was my
    own figure, not a quote. Every line is now read from AliExpress with the right
    option selected on the listing page.
    Three things came out of it:
    - A search result shows the cheapest variant in the listing, not the part.
    "MGN12H ... A$1.49" is a 100 mm MGN7 rail; the 500 mm MGN12H is A$38.01.
    - There is a first-order voucher under the sale price. One seller's three rail
    lengths fit sale = 0.73 x list - 17.00 exactly, floored at A$1.49 - which is
    why a 5 m and a 10 m belt both showed A$1.49. The 27% repeats, the $17 does
    not, so the BOM to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
    [idex-printer-assembly.f3d, idex-printer-assembly.step, mass-report.csv, parameters.csv]
2026-11-11 Build spec lesson 24: what an overseas price is, and the check that caught the BOM
2026-11-12 Add the enclosure, and fold the X motors in to make room for it
    The plan was to skin the frame: it is 20-series V-slot throughout and 6 mm
    Bubbleboard drops straight into a 6 mm slot. Reading the side elevation out of
    the model killed that. Above the base rectangle there are two uprights and one
    top tie, all at mid-depth, and nothing at the front or back. Correct for a
    bedslinger, since the bed slings through where the walls would be, but it means
    there are no slots in the right places. The enclosure is a cage, not a skin.
    Six things also stuck out past the frame, the widest being the X motors: the
    42.4 mm body and 50 mm mount plate sit on a pulley 10 mm from the beam end, so
    both hang over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
    [idex-printer-assembly.f3d, idex-printer-assembly.step, mass-report.csv, parameters.csv]
2026-11-12 Mount the electronics on one sheet, on a 2020 ladder that carries the load
    The ask was a single Bubbleboard sheet for all the electronics. Section 25 had
    argued against it on sag and pull-through, and the numbers say that was wrong:
    the panel is vertical, so gravity acts in its plane and the sheet is a plate in
    edge compression, not a beam in bending. 2.5 kg over a 520 mm bottom edge is
    47 N/m against a critical ~388 N/m, an 8x margin, and the worst bolt sees 3.2 N
    of bearing against ~120 N.
    What the model actually held was worse than either side of that argument: the
    "Electronics panel" was a 440 x 40 mm aluminium strip at the very bottom, with
    2.5 kg of supplies and board cantilevered up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
    [idex-printer-assembly.f3d, idex-printer-assembly.step, mass-report.csv, parameters.csv]
